Arkrez/bob/cad/rocky_bob/lidar_guard_options.png

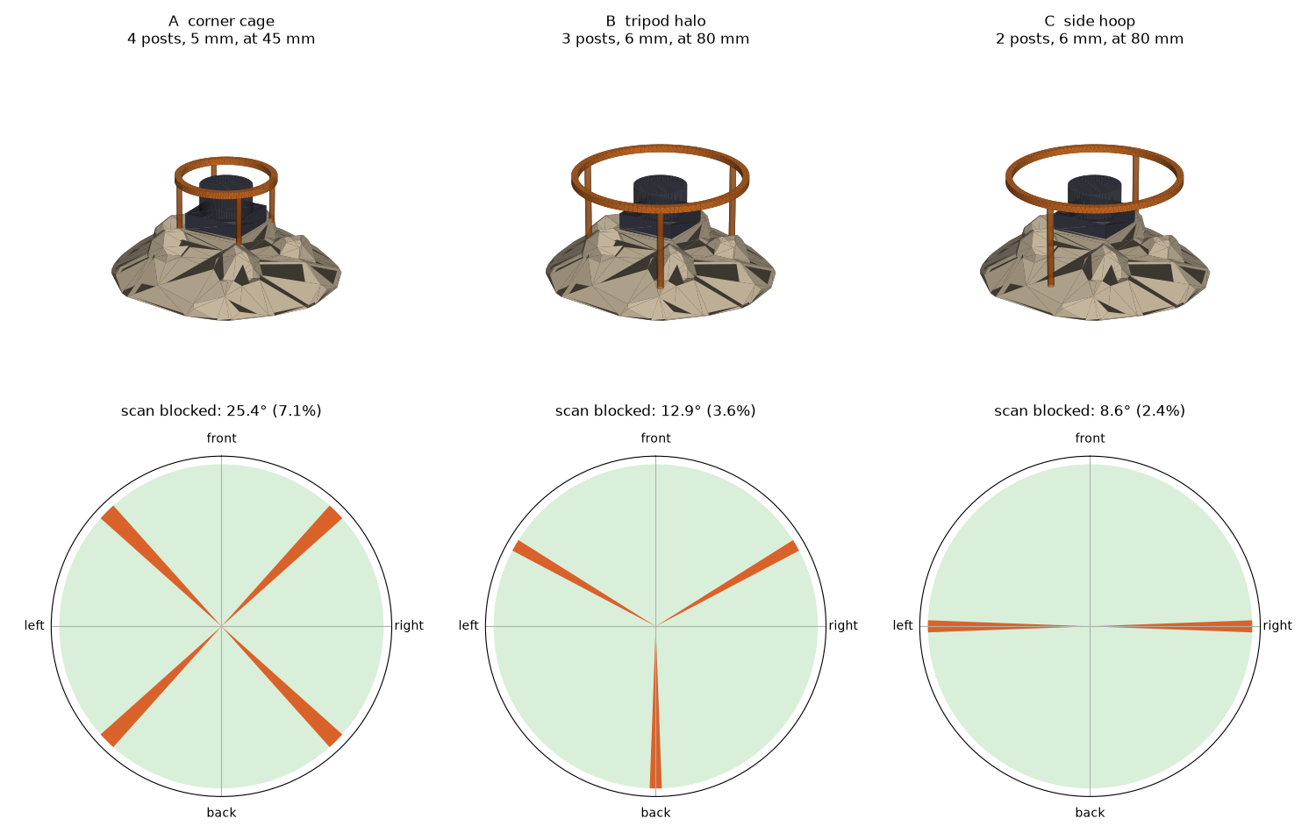
cad/rocky_bob/lidar_guard_options.png
