Arkrez/bob/cad/rocky_bob/tof_nose.png

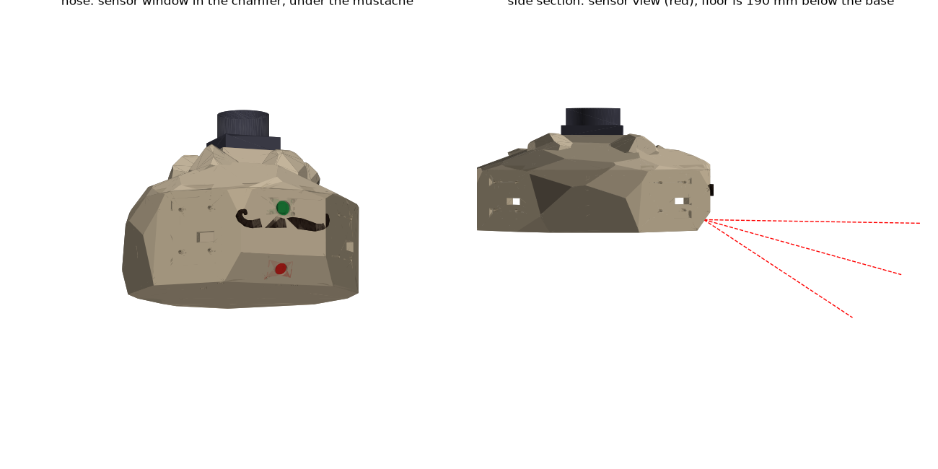
cad/rocky_bob/tof_nose.png
