Arkrez/bob/rl/stairs_terrain.png

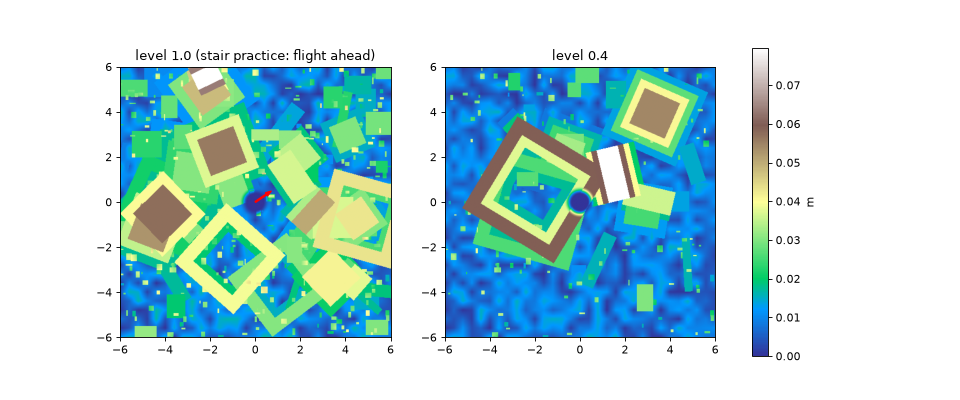
rl/stairs_terrain.png
