Arkrez/bob/webots_quadruped/worlds/.quadruped.jpg

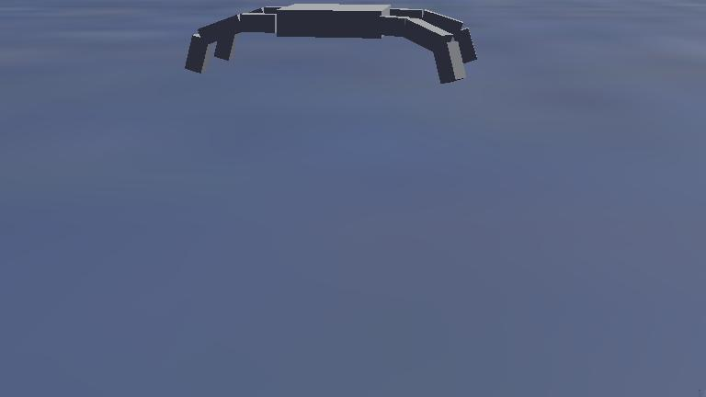
webots_quadruped/worlds/.quadruped.jpg
