Arkrez/bob/cad/rocky_bob/step/rocky_bob_assembly.step

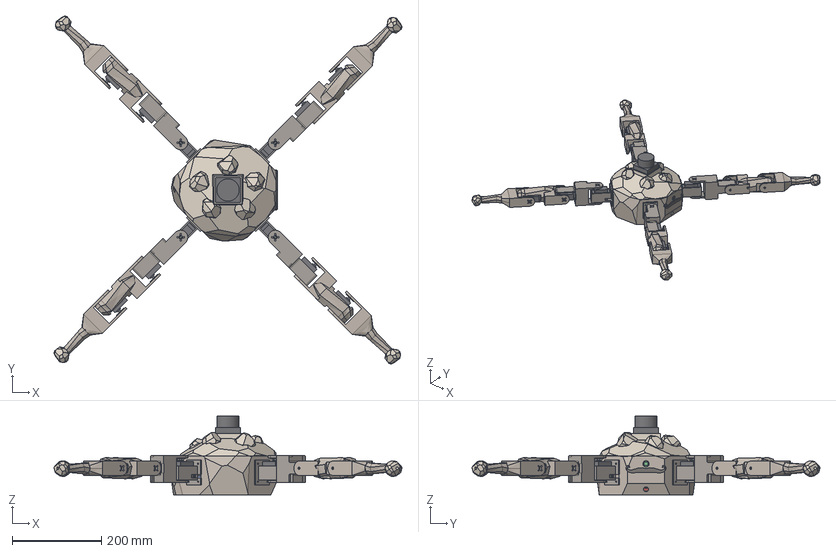
[picture p12: CAD file, 2026-10-24]
cad/rocky_bob/step/rocky_bob_assembly.step
781.7 x 781.7 x 177.3 mm
rock_base
rock_lid
pi5
servo2040
psu
pi_camera
mustache
tof
lidar
leg0_hip_pod x 4
leg0_servo_hip_yaw x 4
leg0_horn_hip_yaw x 4
leg0_coxa x 4
leg0_servo_hip_pitch x 4
leg0_horn_hip_pitch x 4
leg0_femur x 4
leg0_servo_knee x 4
leg0_horn_knee x 4
leg0_tibia x 4
leg0_foot x 4
