Arkrez/bob/cad/rocky_bob/step/mustache.step

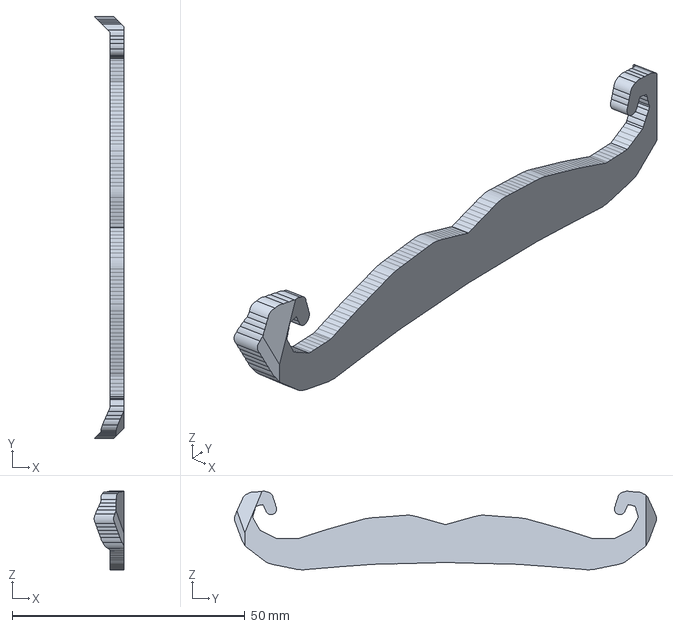
[picture p14: CAD file, 2026-10-24]
cad/rocky_bob/step/mustache.step
6.39 x 90.7 x 16.9 mm
