Arkrez/bob/src/bob_description/meshes/leg1_part2.stl

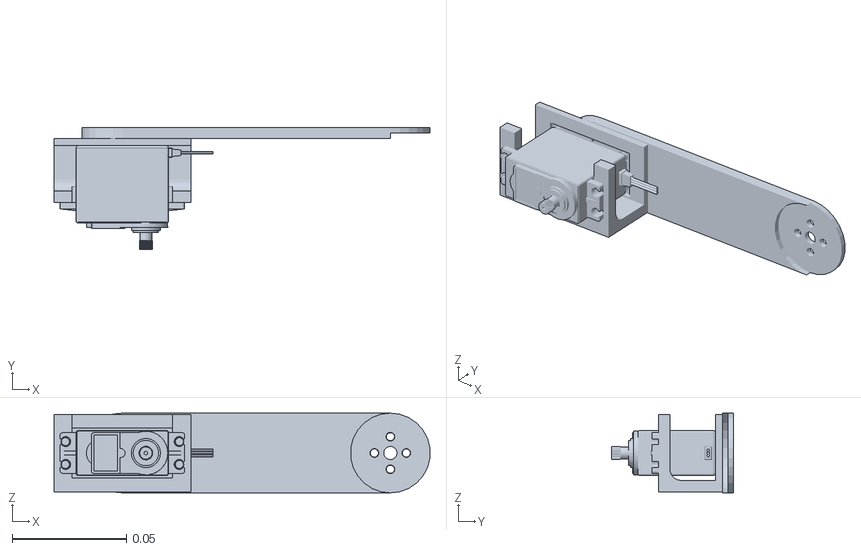
[picture p15: CAD file, 2026-10-13]
src/bob_description/meshes/leg1_part2.stl
0.165 x 0.0537 x 0.035
