Arkrez/bob/src/quadruped_sim/urdf/Quadruped_3D_STL_Files/Stand Link 00.stl

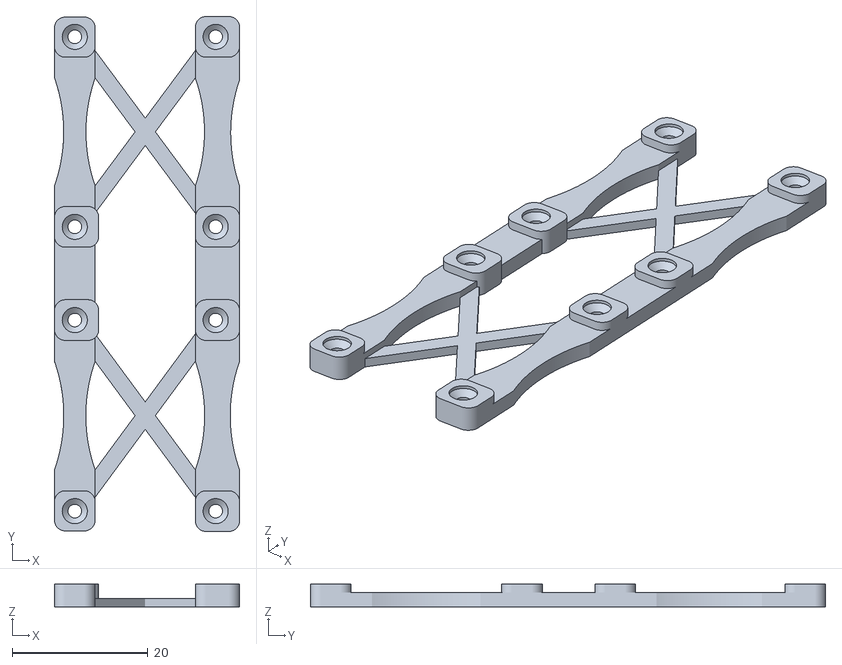
[picture p16: CAD file, 2026-10-04]
src/quadruped_sim/urdf/Quadruped_3D_STL_Files/Stand Link 00.stl
27.3 x 75.9 x 3.35
