Arkrez/bob/webots_quadruped/meshes/leg2_part0.stl

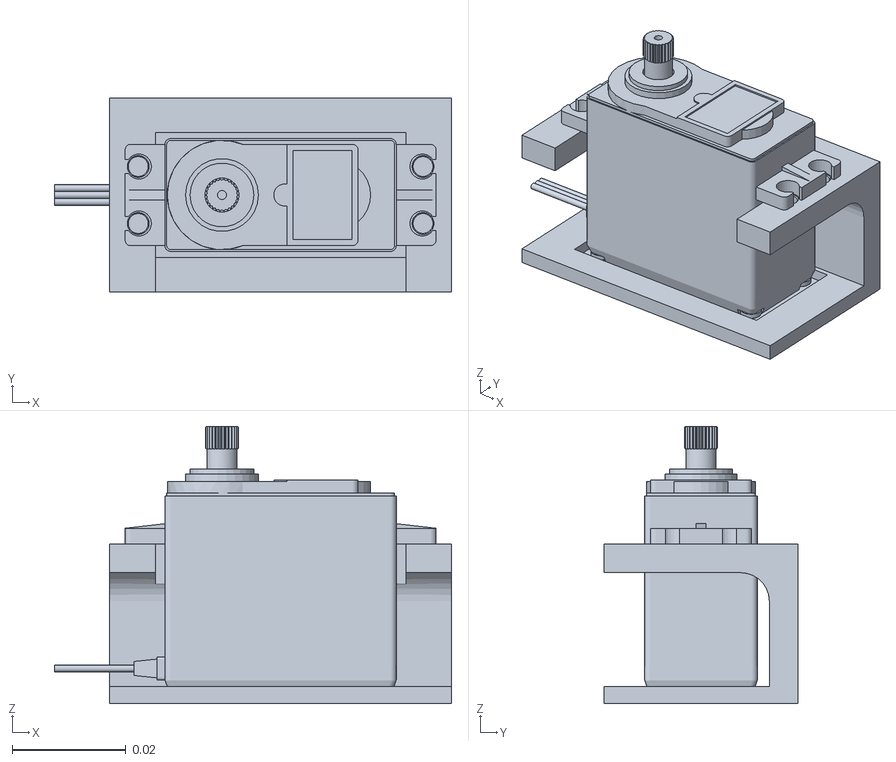
[picture p17: CAD file, 2026-10-13]
webots_quadruped/meshes/leg2_part0.stl
0.0697 x 0.034 x 0.0487
