Arkrez/bob/cad/rocky_bob/sim/meshes/rock_base.stl

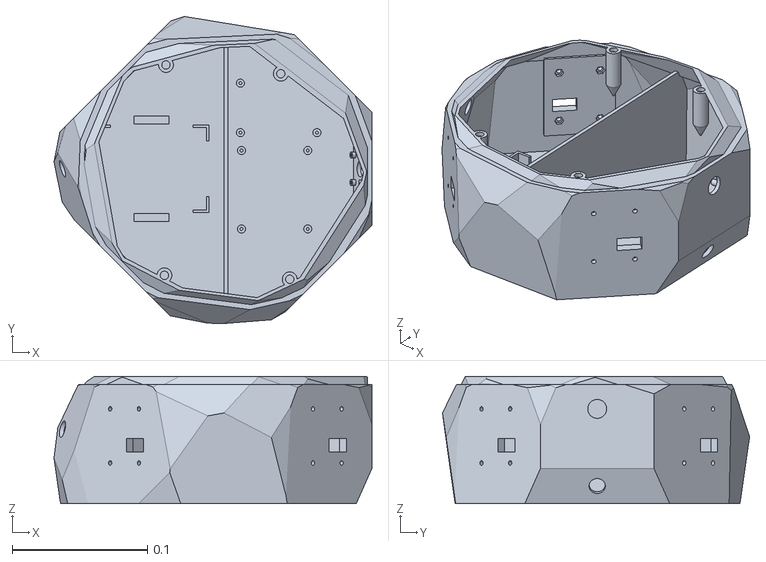
[picture p18: CAD file, 2026-10-24]
cad/rocky_bob/sim/meshes/rock_base.stl
0.235 x 0.227 x 0.094
