Arkrez/bob/cad/rocky_bob/step/rock_base.step

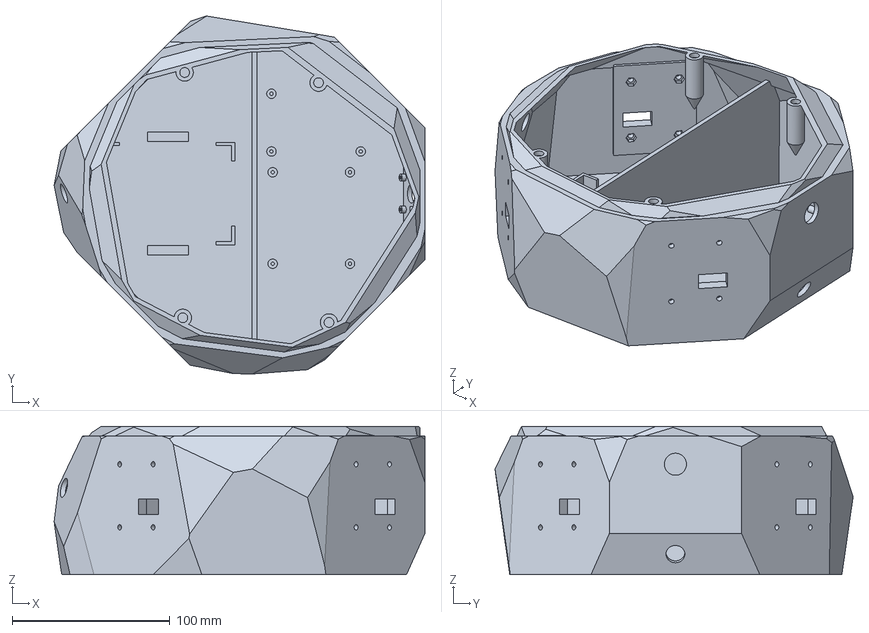
[picture p19: CAD file, 2026-10-24]
cad/rocky_bob/step/rock_base.step
235.1 x 227.0 x 94.0 mm
