Arkrez/bob/src/bob_description/meshes/leg1_part1.stl

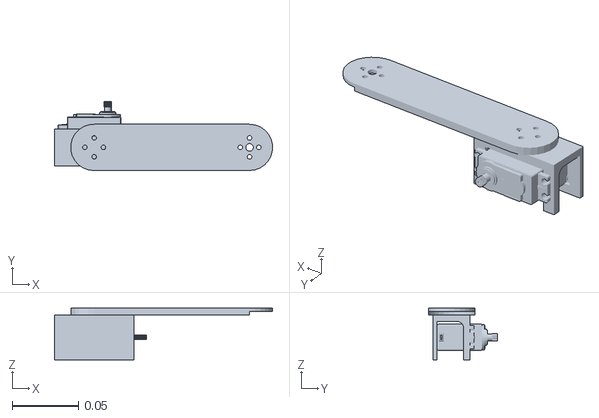
[picture p20: CAD file, 2026-10-13]
src/bob_description/meshes/leg1_part1.stl
0.165 x 0.0522 x 0.039
