Arkrez/bob/src/quadruped_sim/urdf/Quadruped_3D_STL_Files/Body Upper Plate 00.stl

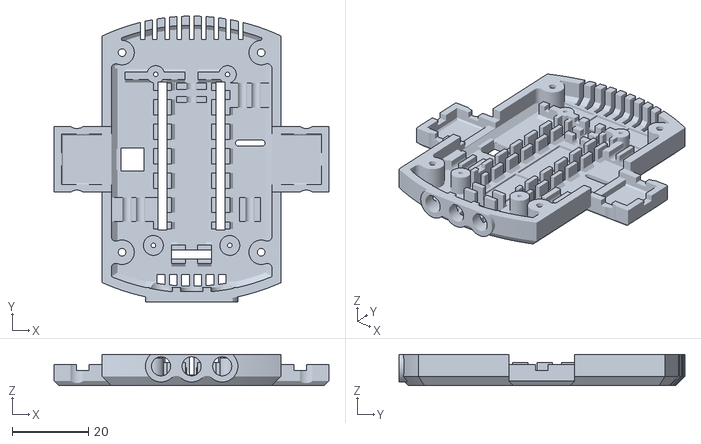
[picture p21: CAD file, 2026-10-04]
src/quadruped_sim/urdf/Quadruped_3D_STL_Files/Body Upper Plate 00.stl
71.9 x 74.8 x 8.15
