Arkrez/bob/cad/rocky_bob/sim/meshes/rock_lid.stl

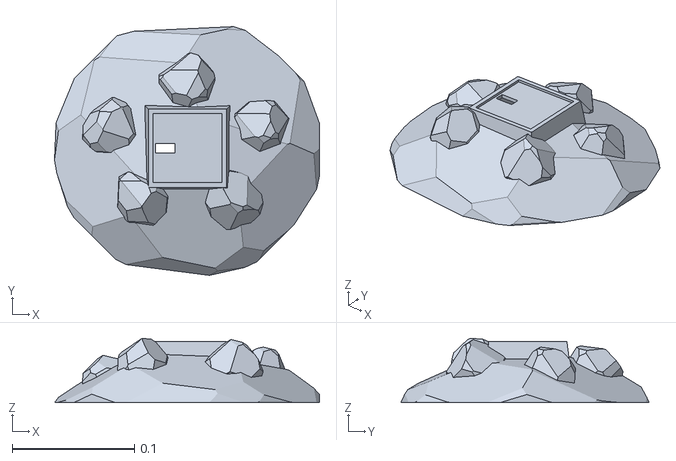
[picture p22: CAD file, 2026-10-24]
cad/rocky_bob/sim/meshes/rock_lid.stl
0.217 x 0.204 x 0.0527
