Arkrez/bob/cad/rocky_bob/step/coxa.step

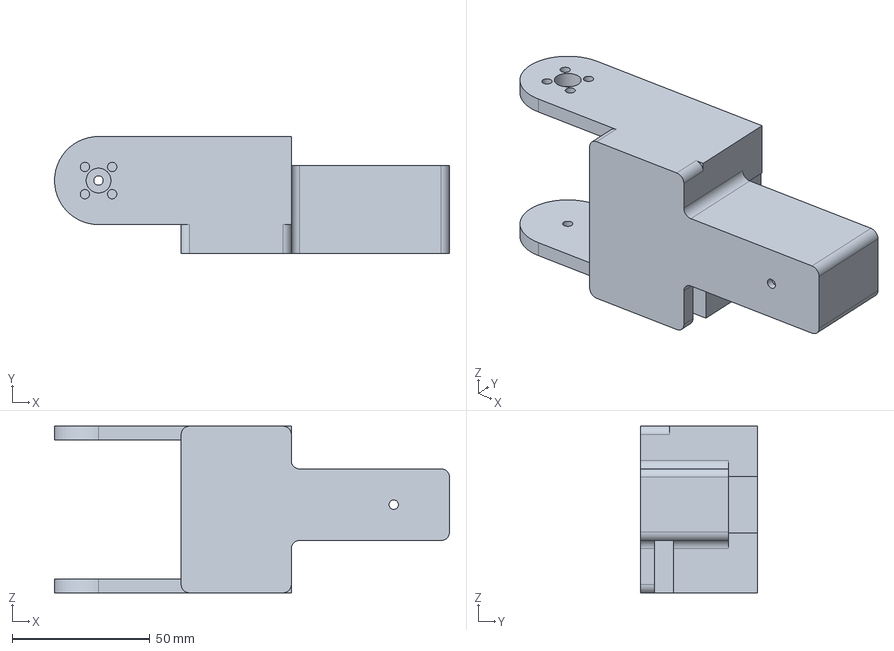
[picture p23: CAD file, 2026-10-24]
cad/rocky_bob/step/coxa.step
143.4 x 42.5 x 60.5 mm
