Arkrez/bob/src/bob_description/meshes/leg0_part3.stl

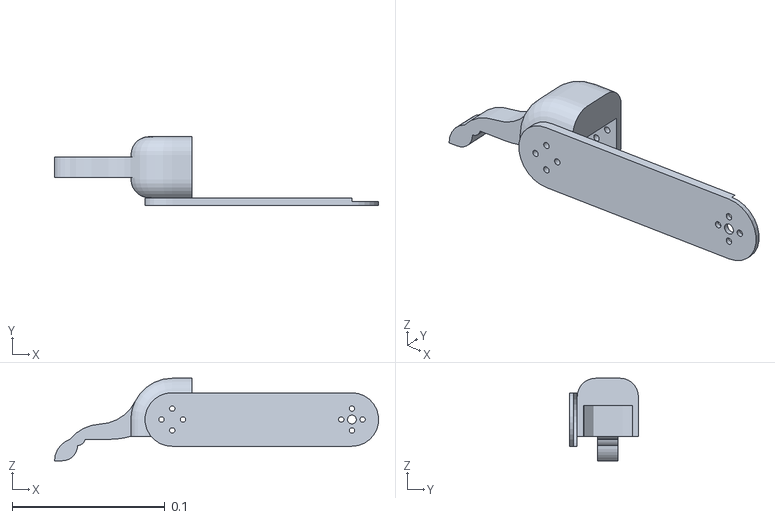
[picture p24: CAD file, 2026-10-13]
src/bob_description/meshes/leg0_part3.stl
0.212 x 0.045 x 0.054
