Arkrez/bob/src/quadruped_sim/urdf/Quadruped_3D_STL_Files/Cross Joint 00.stl

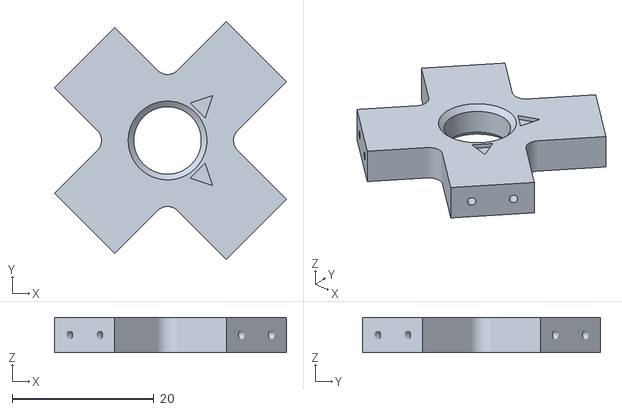
[picture p25: CAD file, 2026-10-04]
src/quadruped_sim/urdf/Quadruped_3D_STL_Files/Cross Joint 00.stl
32.7 x 33.6 x 5.00
