Arkrez/bob/cad/rocky_bob/sim/meshes/mustache.stl

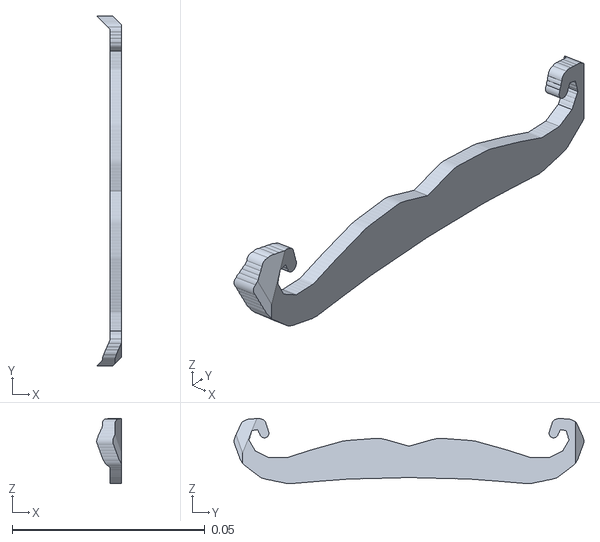
[picture p26: CAD file, 2026-10-24]
cad/rocky_bob/sim/meshes/mustache.stl
0.00639 x 0.0907 x 0.0169
