Arkrez/bob/cad/rocky_bob/step/rock_lid.step

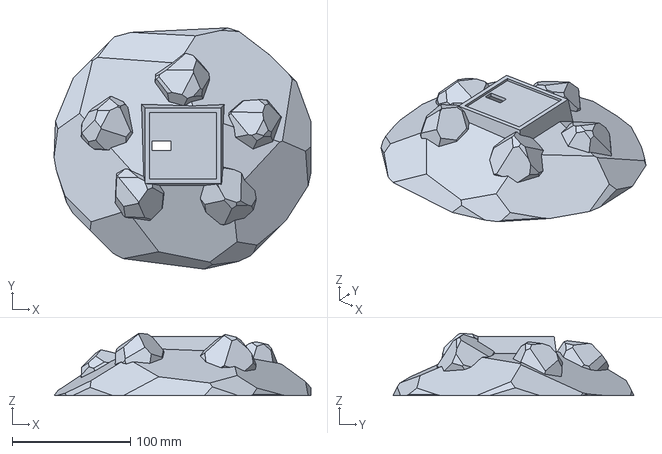
[picture p27: CAD file, 2026-10-24]
cad/rocky_bob/step/rock_lid.step
217.0 x 203.7 x 52.7 mm
