Arkrez/bob/src/bob_description/meshes/base_link.stl

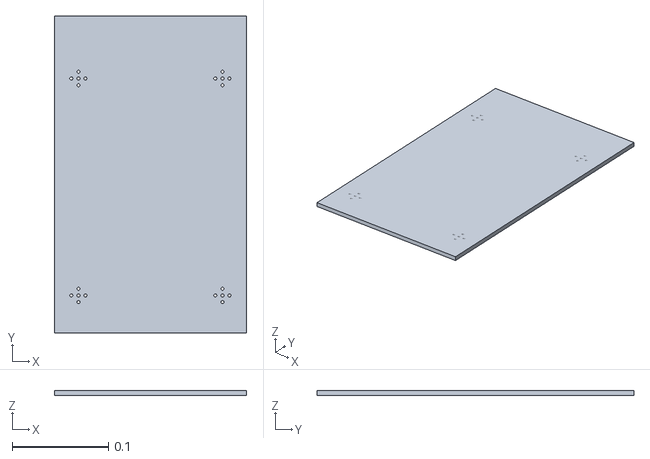
[picture p28: CAD file, 2026-10-13]
src/bob_description/meshes/base_link.stl
0.2 x 0.33 x 0.005
