Arkrez/bob/src/quadruped_sim/urdf/Quadruped_3D_STL_Files/Stand End Plate 00.stl

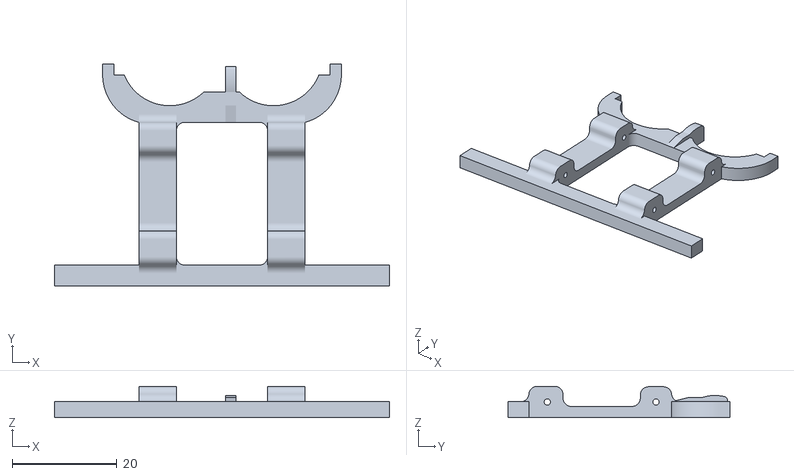
[picture p29: CAD file, 2026-10-04]
src/quadruped_sim/urdf/Quadruped_3D_STL_Files/Stand End Plate 00.stl
64.0 x 42.4 x 6.00
