Arkrez/bob/cad/rocky_bob/sim/meshes/lidar.stl

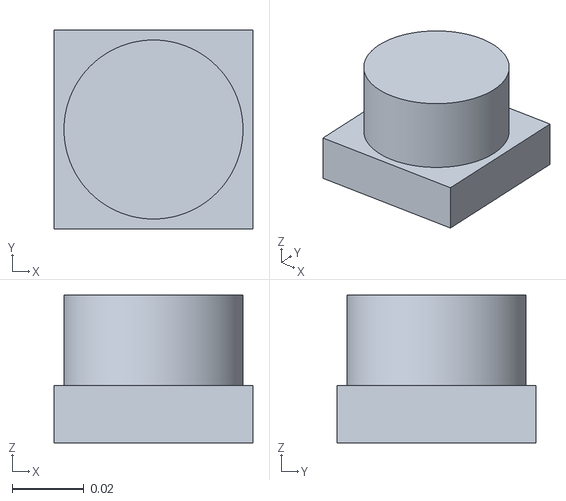
[picture p30: CAD file, 2026-10-24]
cad/rocky_bob/sim/meshes/lidar.stl
0.0556 x 0.0556 x 0.0413
