Arkrez/bob/cad/rocky_bob/step/tibia.step

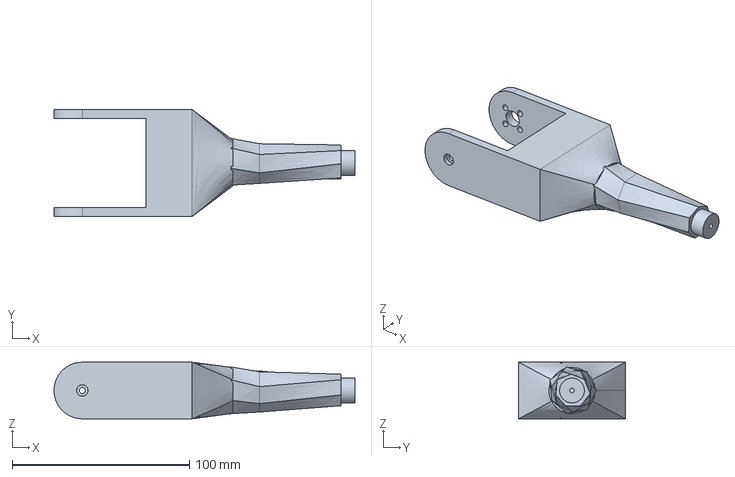
[picture p31: CAD file, 2026-10-24]
cad/rocky_bob/step/tibia.step
170.0 x 60.5 x 32.0 mm
