Arkrez/bob/src/quadruped_sim/urdf/Quadruped_3D_STL_Files/Servo Base Plate 00.stl

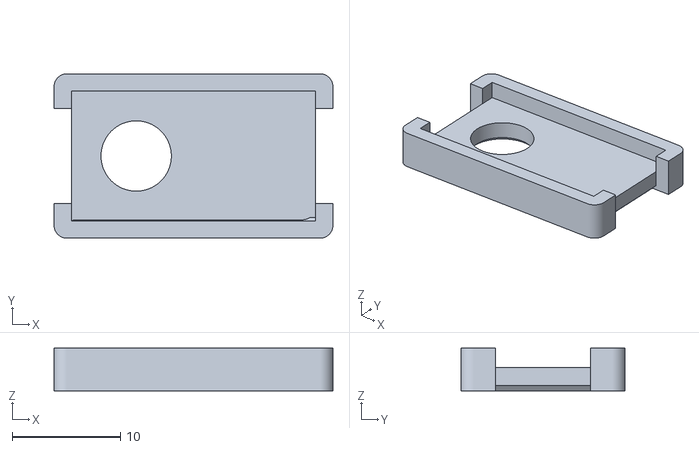
[picture p32: CAD file, 2026-10-04]
src/quadruped_sim/urdf/Quadruped_3D_STL_Files/Servo Base Plate 00.stl
25.8 x 15.2 x 3.95
