Arkrez/bob/cad/rocky_bob/sim/meshes/tof.stl

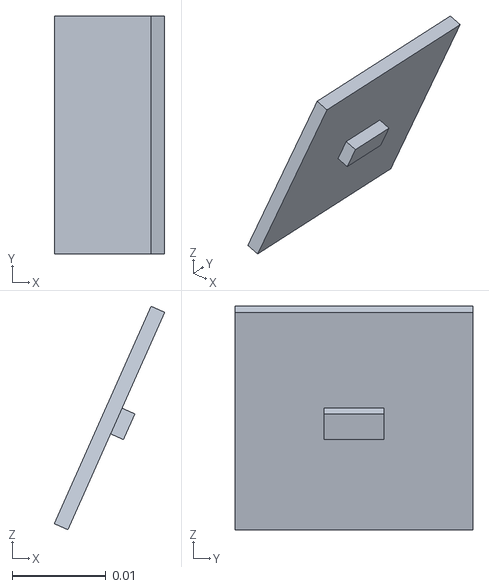
[picture p33: CAD file, 2026-10-24]
cad/rocky_bob/sim/meshes/tof.stl
0.0118 x 0.0254 x 0.0239
