Arkrez/bob/src/quadruped_sim/urdf/Quadruped_3D_STL_Files/Head Face 00.stl

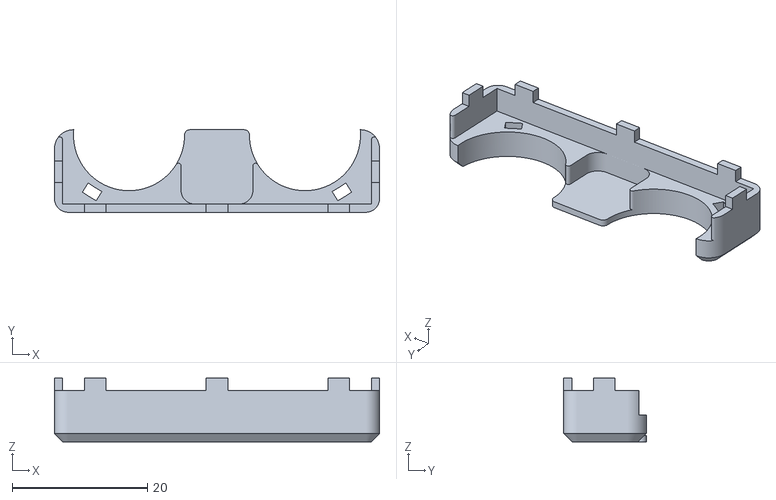
[picture p34: CAD file, 2026-10-04]
src/quadruped_sim/urdf/Quadruped_3D_STL_Files/Head Face 00.stl
48.0 x 12.2 x 9.40
