Arkrez/bob/cad/rocky_bob/sim/meshes/coxa.stl

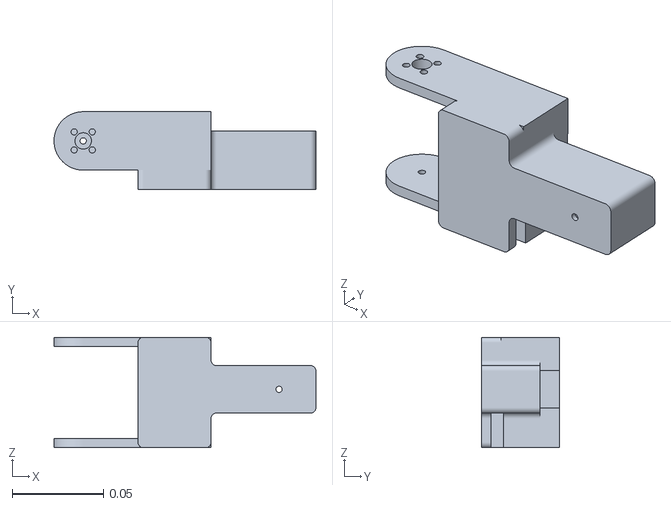
[picture p35: CAD file, 2026-10-23]
cad/rocky_bob/sim/meshes/coxa.stl
0.143 x 0.0425 x 0.0605
