Arkrez/bob/src/quadruped_sim/urdf/Quadruped_3D_STL_Files/Body 00.stl

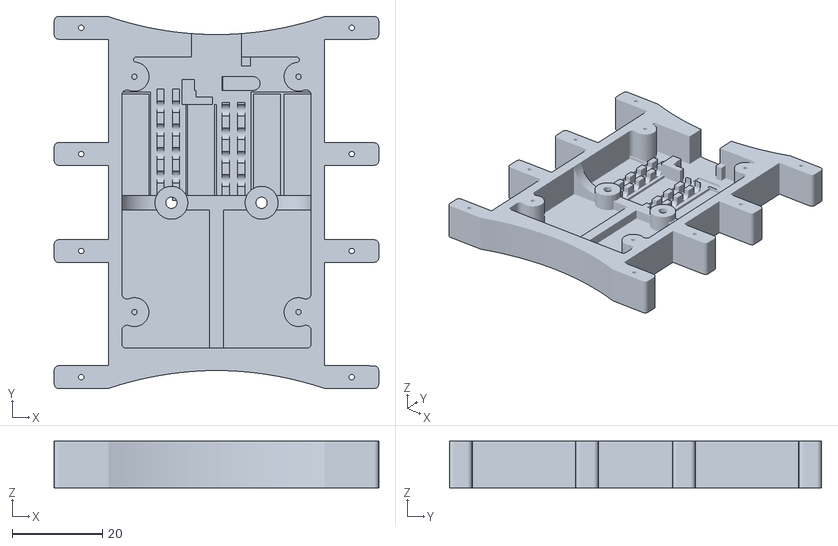
[picture p37: CAD file, 2026-10-04]
src/quadruped_sim/urdf/Quadruped_3D_STL_Files/Body 00.stl
72.0 x 82.5 x 10.4
