Arkrez/bob/cad/rocky_bob/sim/meshes/servo_hip_yaw.stl

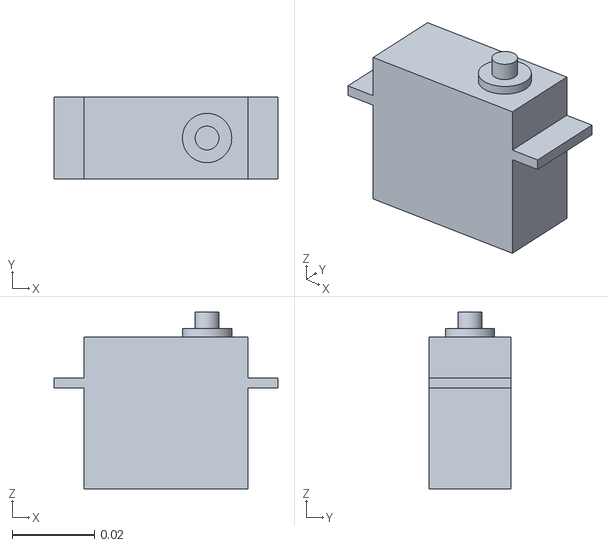
[picture p38: CAD file, 2026-10-23]
cad/rocky_bob/sim/meshes/servo_hip_yaw.stl
0.0545 x 0.02 x 0.043
