Arkrez/bob/cad/rocky_bob/step/foot.step

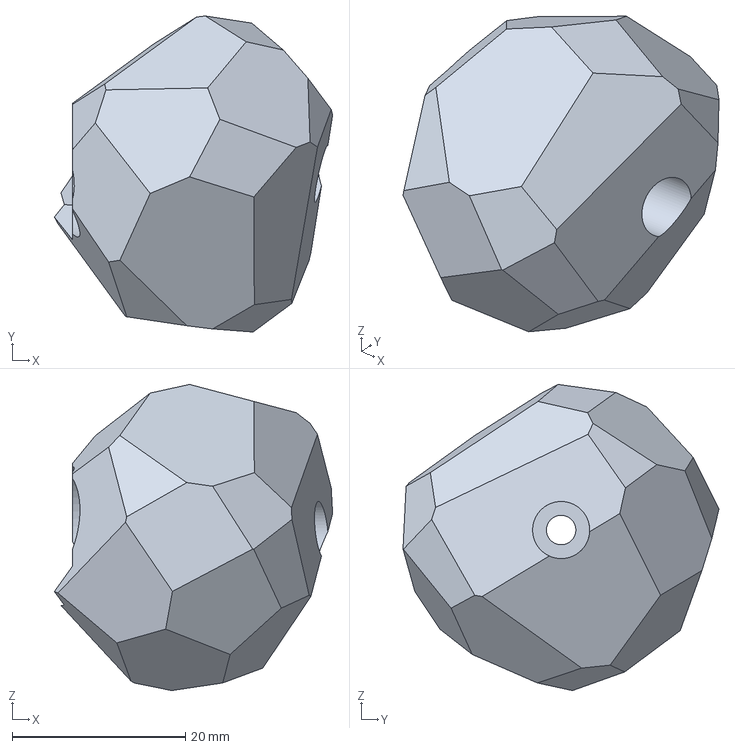
[picture p39: CAD file, 2026-10-24]
cad/rocky_bob/step/foot.step
32.2 x 36.5 x 35.4 mm
