Arkrez/bob/src/quadruped_sim/urdf/Quadruped_3D_STL_Files/Wire Support 00.stl

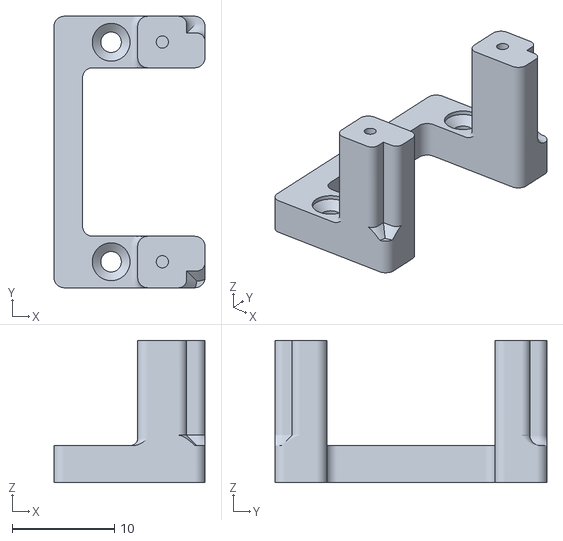
[picture p40: CAD file, 2026-10-04]
src/quadruped_sim/urdf/Quadruped_3D_STL_Files/Wire Support 00.stl
14.8 x 26.6 x 14.0
