Arkrez/bob/cad/rocky_bob/sim/meshes/servo_knee.stl

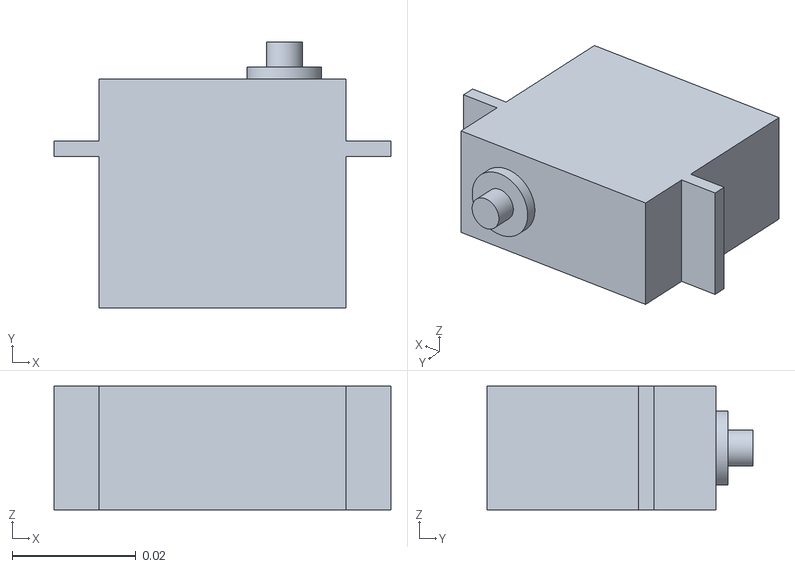
[picture p41: CAD file, 2026-10-23]
cad/rocky_bob/sim/meshes/servo_knee.stl
0.0545 x 0.043 x 0.02
