Arkrez/bob/cad/rocky_bob/step/hip_pod.step

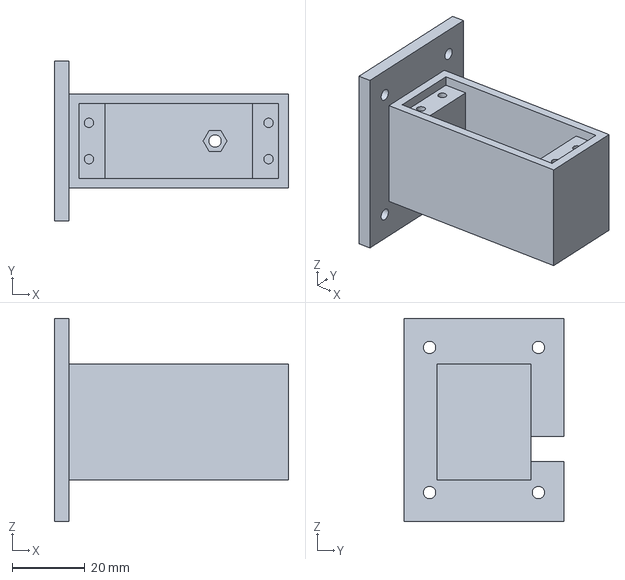
[picture p42: CAD file, 2026-10-24]
cad/rocky_bob/step/hip_pod.step
64.5 x 44.0 x 56.0 mm
