Arkrez/bob/src/quadruped_sim/urdf/Quadruped_3D_STL_Files/Body Lower Plate 00.stl

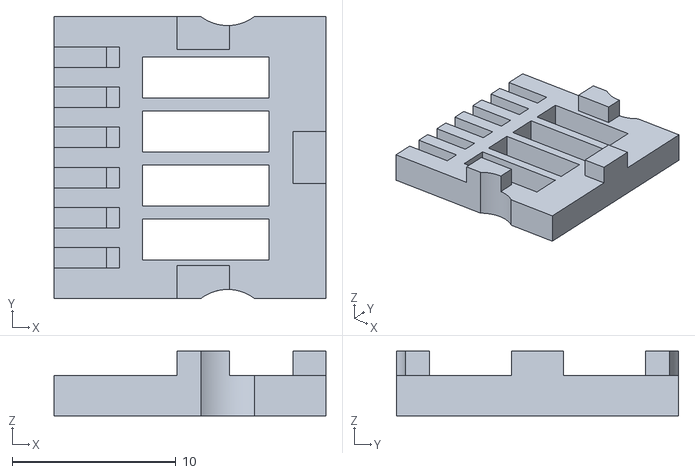
[picture p43: CAD file, 2026-10-04]
src/quadruped_sim/urdf/Quadruped_3D_STL_Files/Body Lower Plate 00.stl
16.6 x 17.2 x 3.95
