Arkrez/bob/cad/rocky_bob/sim/meshes/femur.stl

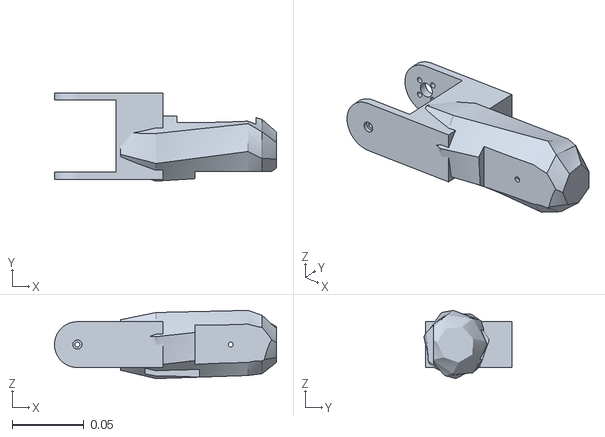
[picture p44: CAD file, 2026-10-23]
cad/rocky_bob/sim/meshes/femur.stl
0.155 x 0.0618 x 0.0477
