Arkrez/bob/cad/rocky_bob/step/femur.step

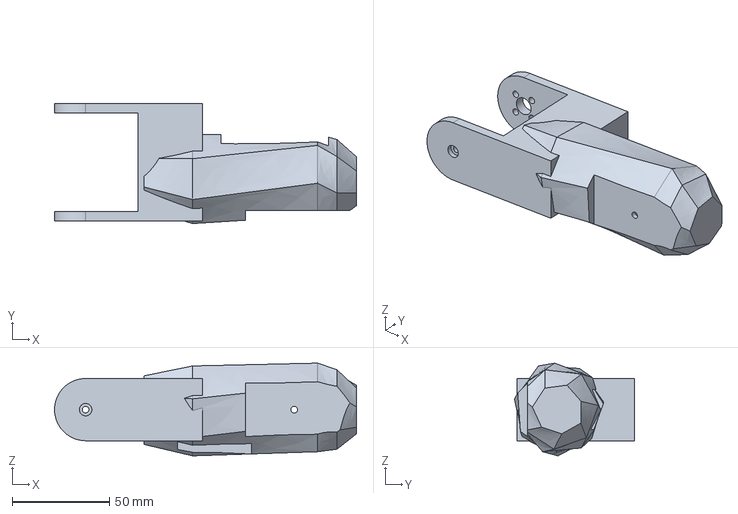
[picture p45: CAD file, 2026-10-24]
cad/rocky_bob/step/femur.step
155.2 x 61.8 x 47.7 mm
