Arkrez/bob/src/quadruped_sim/urdf/Quadruped_3D_STL_Files/Wire Support Cover 00.stl

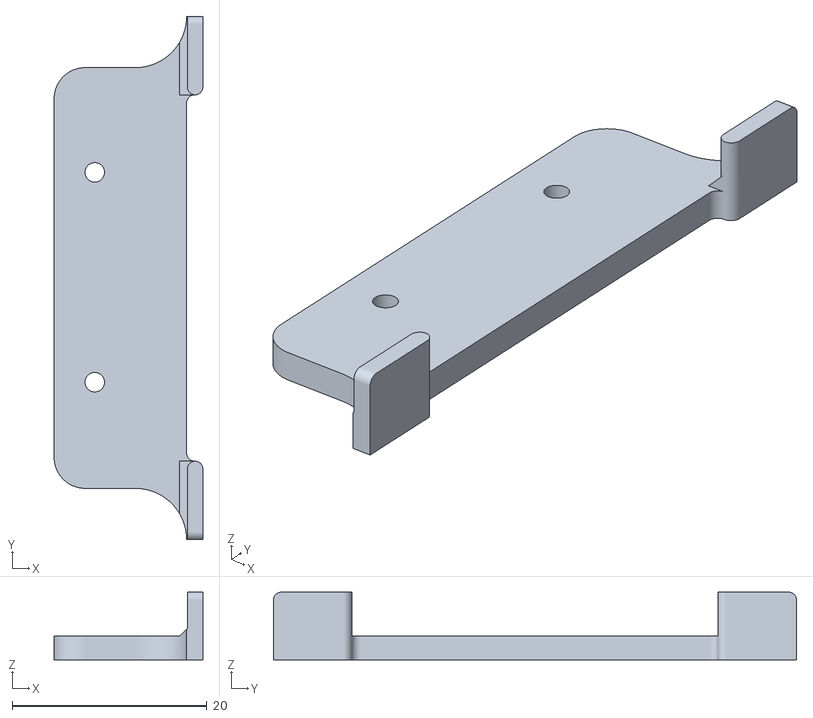
[picture p46: CAD file, 2026-10-04]
src/quadruped_sim/urdf/Quadruped_3D_STL_Files/Wire Support Cover 00.stl
15.3 x 53.7 x 6.95
