Arkrez/bob/cad/rocky_bob/sim/meshes/foot.stl

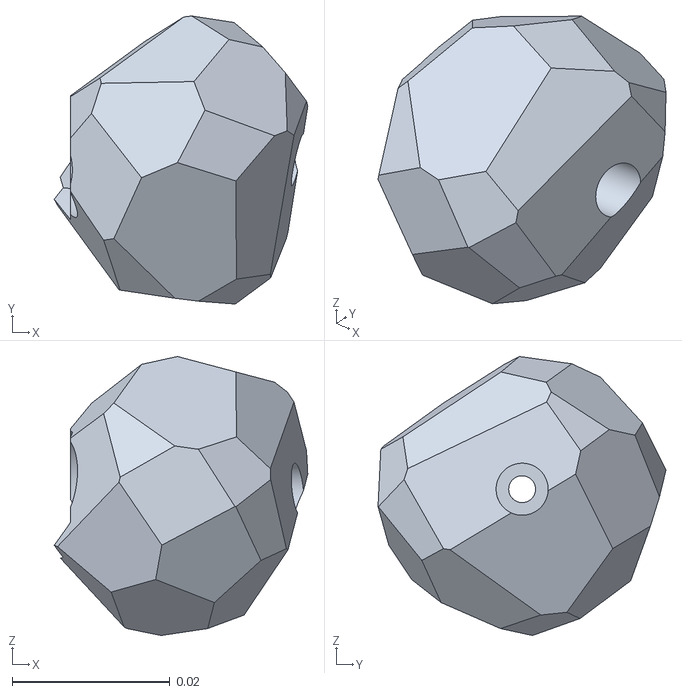
[picture p47: CAD file, 2026-10-23]
cad/rocky_bob/sim/meshes/foot.stl
0.0322 x 0.0365 x 0.0354
