Arkrez/bob/src/quadruped_sim/urdf/Quadruped_3D_STL_Files/Upper Plate 00.stl

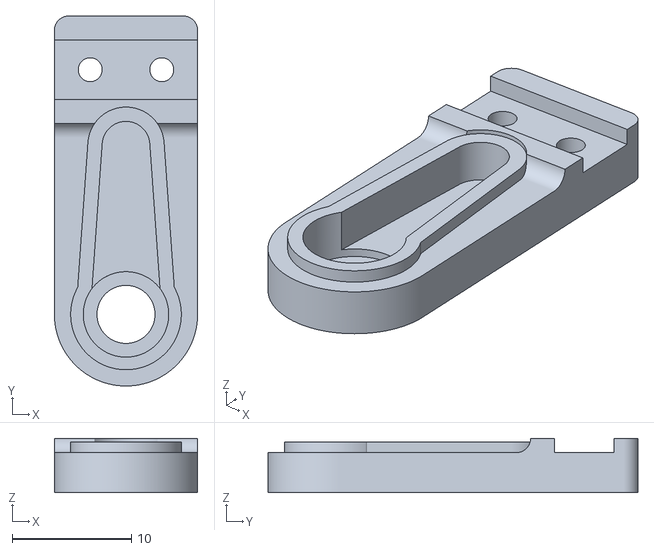
[picture p48: CAD file, 2026-10-04]
src/quadruped_sim/urdf/Quadruped_3D_STL_Files/Upper Plate 00.stl
12.0 x 31.0 x 4.55
