Arkrez/bob/cad/rocky_bob/sim/meshes/tibia.stl

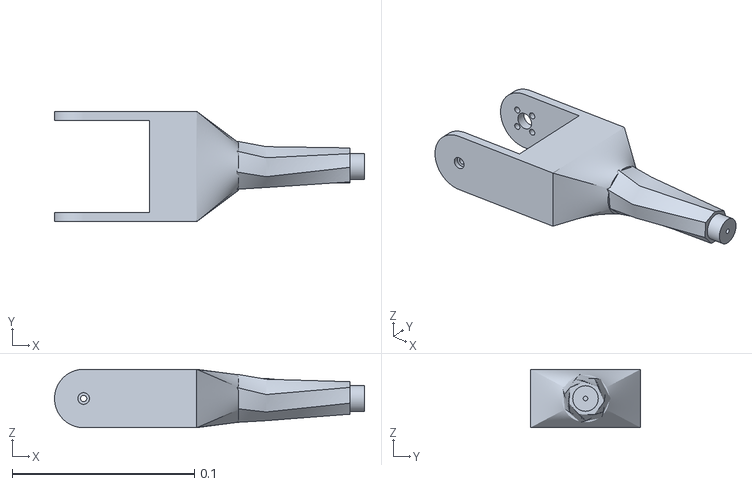
[picture p49: CAD file, 2026-10-23]
cad/rocky_bob/sim/meshes/tibia.stl
0.17 x 0.0605 x 0.032
