Arkrez/bob/cad/rocky_bob/sim/meshes/hip_pod.stl

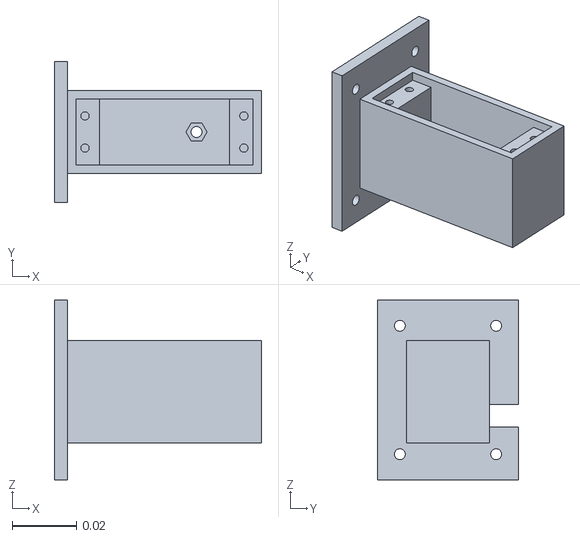
[picture p50: CAD file, 2026-10-23]
cad/rocky_bob/sim/meshes/hip_pod.stl
0.0645 x 0.044 x 0.056
