Arkrez/bob/src/quadruped_sim/urdf/Quadruped_3D_STL_Files/Leg 00.stl

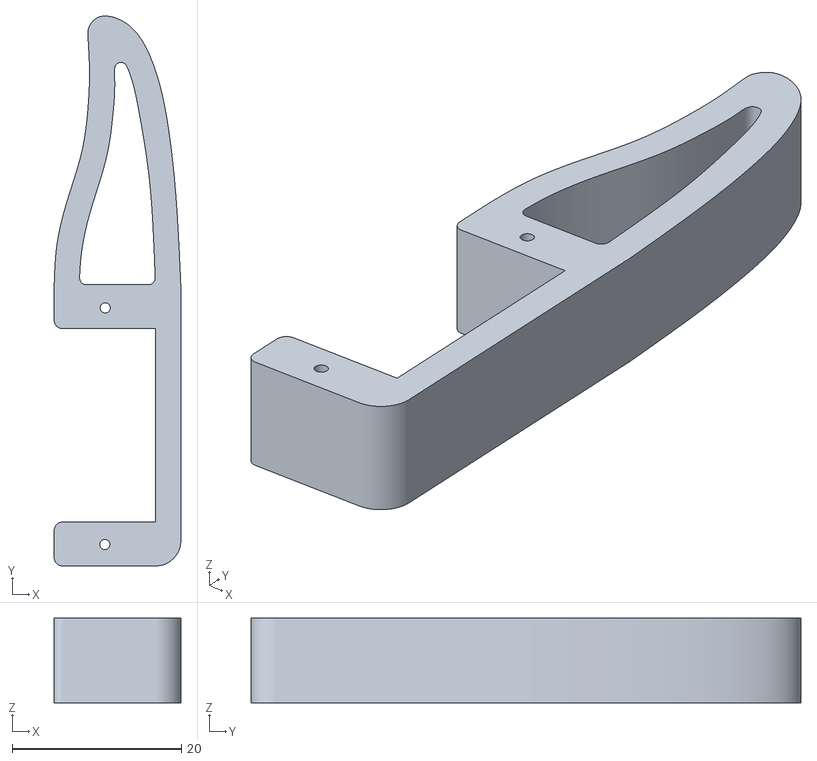
[picture p51: CAD file, 2026-10-04]
src/quadruped_sim/urdf/Quadruped_3D_STL_Files/Leg 00.stl
15.0 x 65.1 x 10.0
