Arkrez/bob/cad/rocky_bob/sim/meshes/pi5.stl

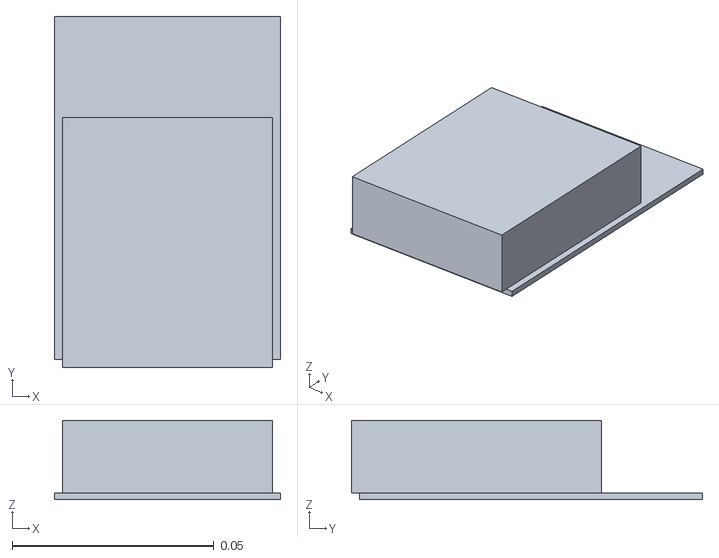
[picture p52: CAD file, 2026-10-23]
cad/rocky_bob/sim/meshes/pi5.stl
0.056 x 0.087 x 0.0196
