Arkrez/bob/src/quadruped_sim/urdf/Quadruped_3D_STL_Files/Battery Connector 00.stl

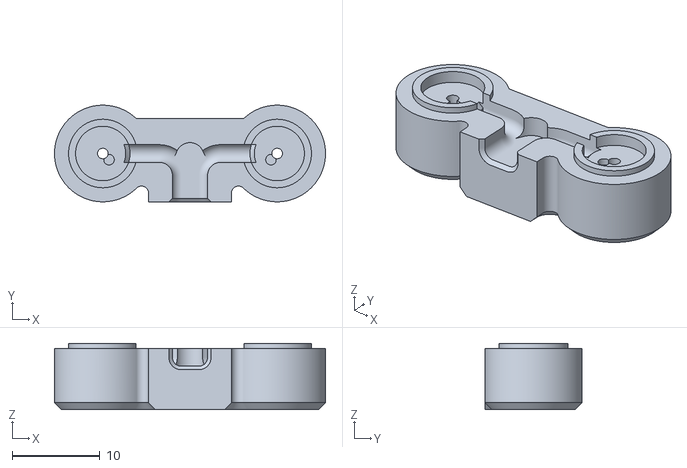
[picture p53: CAD file, 2026-10-04]
src/quadruped_sim/urdf/Quadruped_3D_STL_Files/Battery Connector 00.stl
30.8 x 11.0 x 7.55
