Arkrez/bob/cad/rocky_bob/sim/meshes/horn_knee.stl

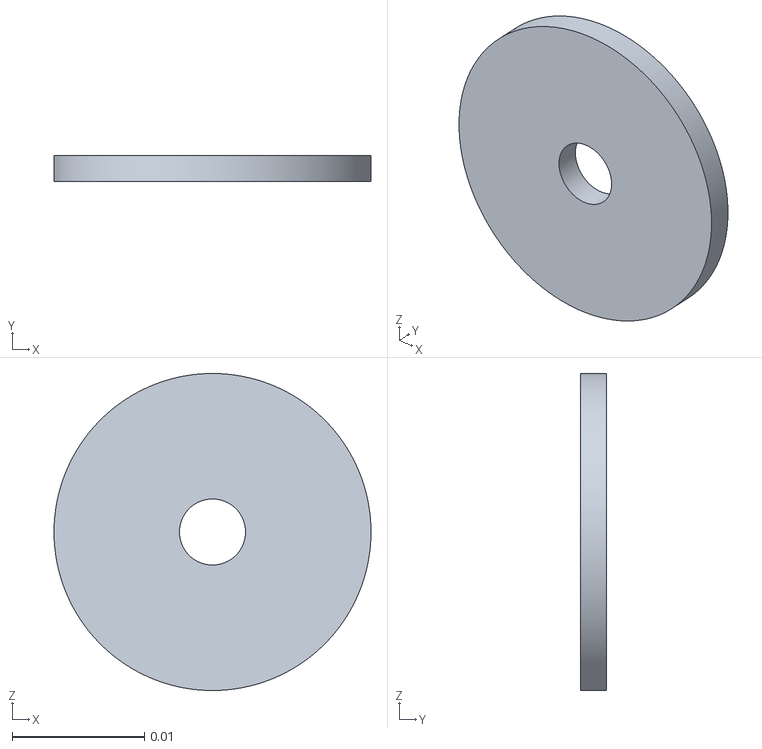
[picture p54: CAD file, 2026-10-23]
cad/rocky_bob/sim/meshes/horn_knee.stl
0.024 x 0.002 x 0.024
