Arkrez/bob/src/quadruped_sim/urdf/Quadruped_3D_STL_Files/Head Eyebrow 00.stl

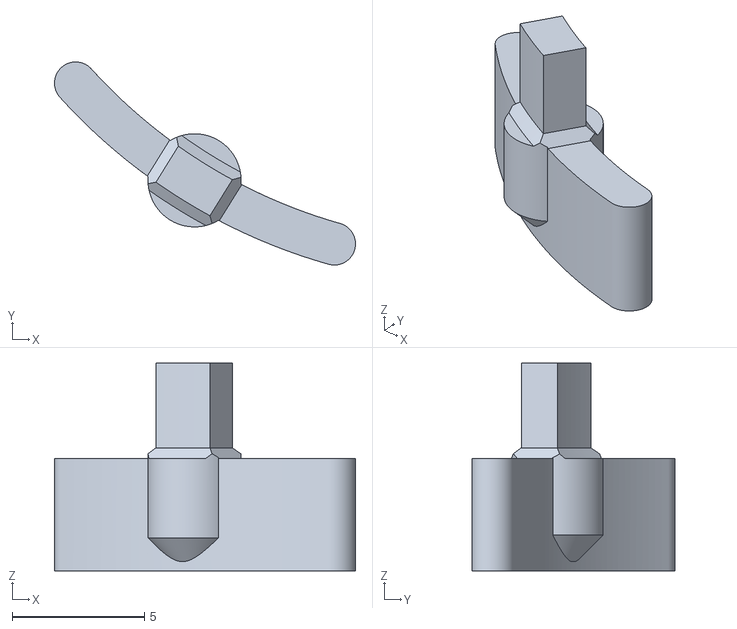
[picture p55: CAD file, 2026-10-04]
src/quadruped_sim/urdf/Quadruped_3D_STL_Files/Head Eyebrow 00.stl
11.4 x 7.67 x 7.85
