Arkrez/bob/src/quadruped_sim/urdf/Quadruped_3D_STL_Files/Lower Plate 00.stl

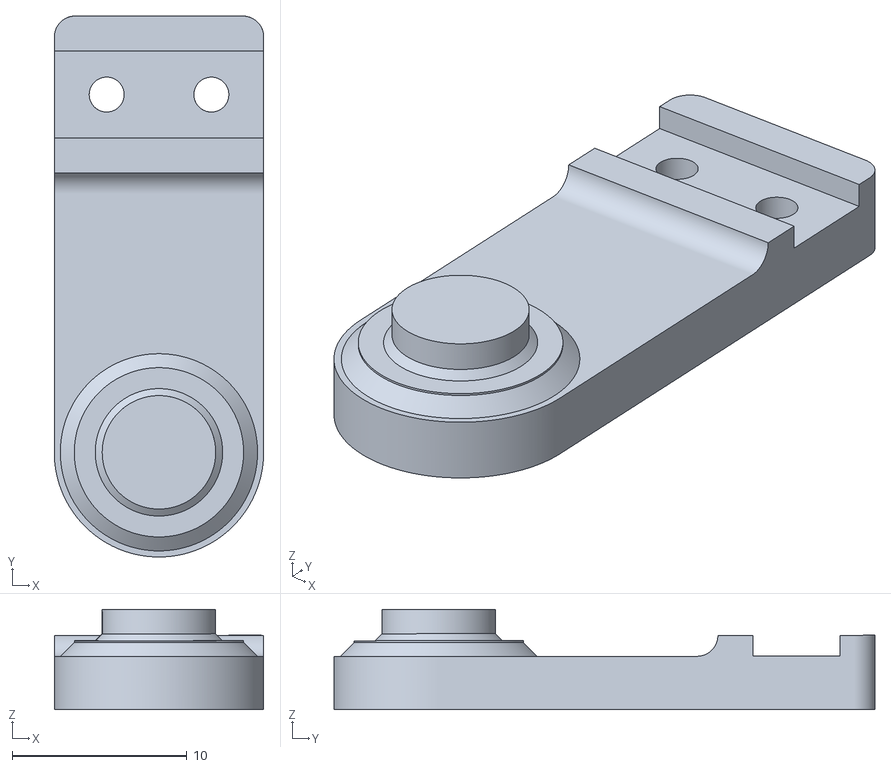
[picture p56: CAD file, 2026-10-04]
src/quadruped_sim/urdf/Quadruped_3D_STL_Files/Lower Plate 00.stl
12.0 x 31.0 x 5.76
