Arkrez/bob/cad/rocky_bob/sim/meshes/pi_camera.stl

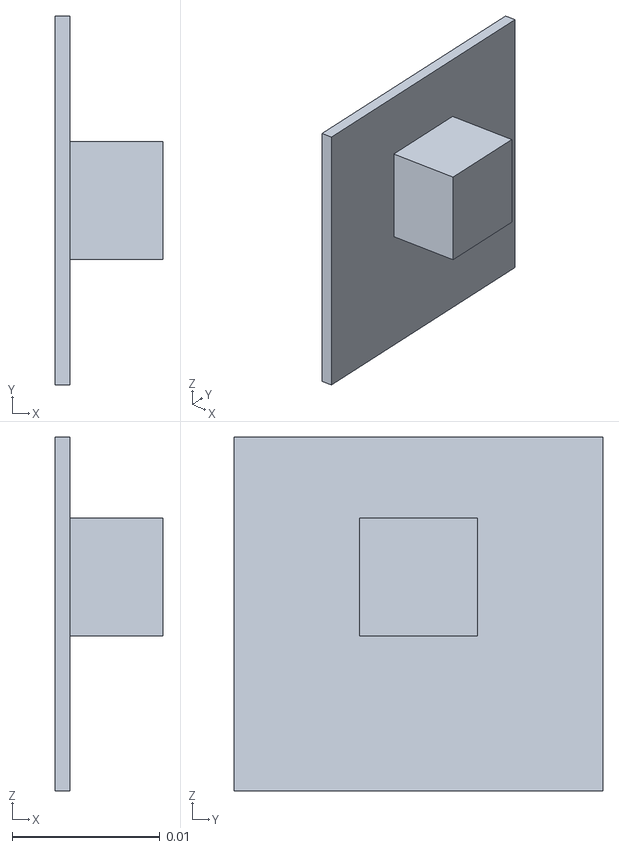
[picture p57: CAD file, 2026-10-23]
cad/rocky_bob/sim/meshes/pi_camera.stl
0.0073 x 0.025 x 0.024
