Arkrez/bob/cad/rocky_bob/sim/meshes/servo2040.stl

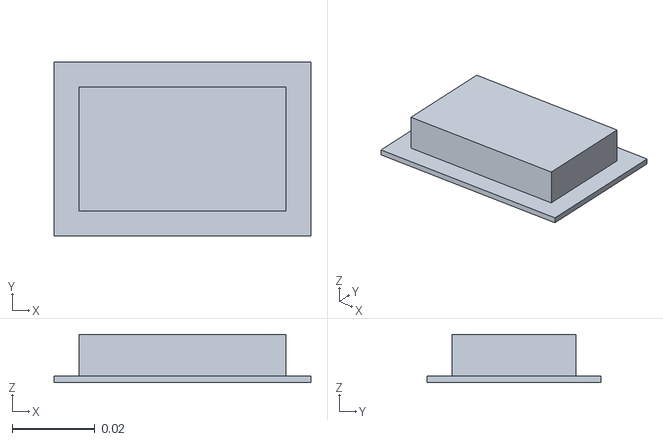
[picture p58: CAD file, 2026-10-23]
cad/rocky_bob/sim/meshes/servo2040.stl
0.062 x 0.042 x 0.0116
