Arkrez/bob/cad/rocky_bob/sim/meshes/psu.stl

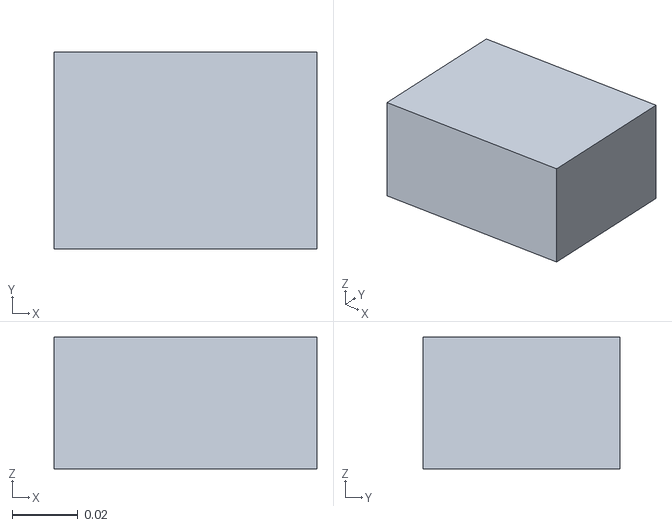
[picture p59: CAD file, 2026-10-23]
cad/rocky_bob/sim/meshes/psu.stl
0.08 x 0.06 x 0.04
