Arkrez/bob/(list of files, cad)

Other CAD files:
webots_quadruped/meshes/leg3_part0.stl
webots_quadruped/meshes/leg3_part2.stl
webots_quadruped/meshes/leg3_part1.stl
src/bob_description/meshes/leg2_part3.stl
webots_quadruped/meshes/leg1_part0.stl
src/bob_description/meshes/leg2_part1.stl
src/quadruped_sim/urdf/Quadruped_3D_STL_Files/Stand Plate 00.stl
cad/rocky_bob/sim/meshes/servo_hip_pitch.stl
cad/rocky_bob/sim/meshes/horn_hip_yaw.stl
cad/rocky_bob/stl/coxa.stl
cad/rocky_bob/stl/femur.stl
cad/rocky_bob/stl/foot.stl
cad/rocky_bob/stl/hip_pod.stl
cad/rocky_bob/stl/mustache.stl
cad/rocky_bob/stl/rock_base.stl
cad/rocky_bob/stl/rock_lid.stl
cad/rocky_bob/stl/tibia.stl
