Arkrez/bob/gz_control_ws/build/gz_ros2_control_demos/symlink_install_manifest.txt

/workspace/gz_control_ws/install/gz_ros2_control_demos/share/gz_ros2_control_demos//launch/ackermann_drive_example.launch.py
/workspace/gz_control_ws/install/gz_ros2_control_demos/share/gz_ros2_control_demos//launch/cart_example_effort.launch.py
/workspace/gz_control_ws/install/gz_ros2_control_demos/share/gz_ros2_control_demos//launch/cart_example_ft_sensor.launch.py
/workspace/gz_control_ws/install/gz_ros2_control_demos/share/gz_ros2_control_demos//launch/cart_example_position.launch.py
/workspace/gz_control_ws/install/gz_ros2_control_demos/share/gz_ros2_control_demos//launch/cart_example_velocity.launch.py
/workspace/gz_control_ws/install/gz_ros2_control_demos/share/gz_ros2_control_demos//launch/cart_example_velocity_custom_plugin.launch.py
/workspace/gz_control_ws/install/gz_ros2_control_demos/share/gz_ros2_control_demos//launch/diff_drive_example.launch.py
/workspace/gz_control_ws/install/gz_ros2_control_demos/share/gz_ros2_control_demos//launch/diff_drive_example_namespaced.launch.py
/workspace/gz_control_ws/install/gz_ros2_control_demos/share/gz_ros2_control_demos//launch/gripper_mimic_joint_example_effort.launch.py
/workspace/gz_control_ws/install/gz_ros2_control_demos/share/gz_ros2_control_demos//launch/gripper_mimic_joint_example_effort.launch.xml
/workspace/gz_control_ws/install/gz_ros2_control_demos/share/gz_ros2_control_demos//launch/gripper_mimic_joint_example_position.launch.py
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
/workspace/gz_control_ws/install/gz_ros2_control_demos/share/gz_ros2_control_demos/environment/library_path.sh
/workspace/gz_control_ws/install/gz_ros2_control_demos/share/gz_ros2_control_demos/environment/library_path.dsv
/workspace/gz_control_ws/install/gz_ros2_control_demos/share/gz_ros2_control_demos//gz_custom_hardware_plugins.xml
/workspace/gz_control_ws/install/gz_ros2_control_demos/share/ament_index/resource_index/package_run_dependencies/gz_ros2_control_demos
/workspace/gz_control_ws/install/gz_ros2_control_demos/share/ament_index/resource_index/parent_prefix_path/gz_ros2_control_demos
/workspace/gz_control_ws/install/gz_ros2_control_demos/share/gz_ros2_control_demos/environment/ament_prefix_path.sh
/workspace/gz_control_ws/install/gz_ros2_control_demos/share/gz_ros2_control_demos/environment/ament_prefix_path.dsv
/workspace/gz_control_ws/install/gz_ros2_control_demos/share/gz_ros2_control_demos/environment/path.sh
/workspace/gz_control_ws/install/gz_ros2_control_demos/share/gz_ros2_control_demos/environment/path.dsv
/workspace/gz_control_ws/install/gz_ros2_control_demos/share/gz_ros2_control_demos/local_setup.bash
/workspace/gz_control_ws/install/gz_ros2_control_demos/share/gz_ros2_control_demos/local_setup.sh
/workspace/gz_control_ws/install/gz_ros2_control_demos/share/gz_ros2_control_demos/local_setup.zsh
/workspace/gz_control_ws/install/gz_ros2_control_demos/share/gz_ros2_control_demos/local_setup.dsv
/workspace/gz_control_ws/install/gz_ros2_control_demos/share/gz_ros2_control_demos/package.dsv
/workspace/gz_control_ws/install/gz_ros2_control_demos/share/ament_index/resource_index/packages/gz_ros2_control_demos
/workspace/gz_control_ws/install/gz_ros2_control_demos/share/ament_index/resource_index/gz_ros2_control__pluginlib__plugin/gz_ros2_control_demos
/workspace/gz_control_ws/install/gz_ros2_control_demos/share/gz_ros2_control_demos/cmake/ament_cmake_export_targets-extras.cmake
/workspace/gz_control_ws/install/gz_ros2_control_demos/share/gz_ros2_control_demos/cmake/gz_ros2_control_demosConfig.cmake
/workspace/gz_control_ws/install/gz_ros2_control_demos/share/gz_ros2_control_demos/cmake/gz_ros2_control_demosConfig-version.cmake
/workspace/gz_control_ws/install/gz_ros2_control_demos/share/gz_ros2_control_demos/package.xml
