Arkrez/bob/build/audio_common/symlink_install_manifest.txt

/workspace/install/audio_common/lib/audio_common/audio_capturer_node
/workspace/install/audio_common/lib/audio_common/audio_player_node
/workspace/install/audio_common/lib/audio_common/music_node
/workspace/install/audio_common/share/audio_common/samples/elevator.wav
/workspace/install/audio_common/lib/audio_common/tts_node
/workspace/install/audio_common/lib/libaudio_common_lib.a
/workspace/install/audio_common/include//audio_common/audio_capturer_node.hpp
/workspace/install/audio_common/include//audio_common/audio_player_node.hpp
/workspace/install/audio_common/include//audio_common/music_node.hpp
/workspace/install/audio_common/include//audio_common/tts_node.hpp
/workspace/install/audio_common/include//audio_common/wave_file.hpp
/workspace/install/audio_common/share/audio_common/environment/library_path.sh
/workspace/install/audio_common/share/audio_common/environment/library_path.dsv
/workspace/install/audio_common/share/ament_index/resource_index/package_run_dependencies/audio_common
/workspace/install/audio_common/share/ament_index/resource_index/parent_prefix_path/audio_common
/workspace/install/audio_common/share/audio_common/environment/ament_prefix_path.sh
/workspace/install/audio_common/share/audio_common/environment/ament_prefix_path.dsv
/workspace/install/audio_common/share/audio_common/environment/path.sh
/workspace/install/audio_common/share/audio_common/environment/path.dsv
/workspace/install/audio_common/share/audio_common/local_setup.bash
/workspace/install/audio_common/share/audio_common/local_setup.sh
/workspace/install/audio_common/share/audio_common/local_setup.zsh
/workspace/install/audio_common/share/audio_common/local_setup.dsv
/workspace/install/audio_common/share/audio_common/package.dsv
/workspace/install/audio_common/share/ament_index/resource_index/packages/audio_common
/workspace/install/audio_common/share/audio_common/cmake/ament_cmake_export_include_directories-extras.cmake
/workspace/install/audio_common/share/audio_common/cmake/ament_cmake_export_libraries-extras.cmake
/workspace/install/audio_common/share/audio_common/cmake/audio_commonConfig.cmake
/workspace/install/audio_common/share/audio_common/cmake/audio_commonConfig-version.cmake
/workspace/install/audio_common/share/audio_common/package.xml
