Arkrez/bob/build/audio_common_msgs/symlink_install_manifest.txt

/workspace/install/audio_common_msgs/share/ament_index/resource_index/rosidl_interfaces/audio_common_msgs
/workspace/install/audio_common_msgs/include/audio_common_msgs/audio_common_msgs/action/detail/tts__functions.h
/workspace/install/audio_common_msgs/include/audio_common_msgs/audio_common_msgs/action/detail/tts__struct.h
/workspace/install/audio_common_msgs/include/audio_common_msgs/audio_common_msgs/action/detail/tts__type_support.h
/workspace/install/audio_common_msgs/include/audio_common_msgs/audio_common_msgs/action/tts.h
/workspace/install/audio_common_msgs/include/audio_common_msgs/audio_common_msgs/msg/audio.h
/workspace/install/audio_common_msgs/include/audio_common_msgs/audio_common_msgs/msg/audio_data.h
/workspace/install/audio_common_msgs/include/audio_common_msgs/audio_common_msgs/msg/audio_info.h
/workspace/install/audio_common_msgs/include/audio_common_msgs/audio_common_msgs/msg/audio_stamped.h
/workspace/install/audio_common_msgs/include/audio_common_msgs/audio_common_msgs/msg/detail/audio__functions.h
/workspace/install/audio_common_msgs/include/audio_common_msgs/audio_common_msgs/msg/detail/audio__struct.h
/workspace/install/audio_common_msgs/include/audio_common_msgs/audio_common_msgs/msg/detail/audio__type_support.h
/workspace/install/audio_common_msgs/include/audio_common_msgs/audio_common_msgs/msg/detail/audio_data__functions.h
/workspace/install/audio_common_msgs/include/audio_common_msgs/audio_common_msgs/msg/detail/audio_data__struct.h
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
/workspace/install/audio_common_msgs/include/audio_common_msgs/audio_common_msgs/action/detail/tts__rosidl_typesupport_introspection_c.h
/workspace/install/audio_common_msgs/include/audio_common_msgs/audio_common_msgs/msg/detail/audio__rosidl_typesupport_introspection_c.h
/workspace/install/audio_common_msgs/include/audio_common_msgs/audio_common_msgs/msg/detail/audio_data__rosidl_typesupport_introspection_c.h
/workspace/install/audio_common_msgs/include/audio_common_msgs/audio_common_msgs/msg/detail/audio_info__rosidl_typesupport_introspection_c.h
/workspace/install/audio_common_msgs/include/audio_common_msgs/audio_common_msgs/msg/detail/audio_stamped__rosidl_typesupport_introspection_c.h
/workspace/install/audio_common_msgs/include/audio_common_msgs/audio_common_msgs/msg/rosidl_typesupport_introspection_c__visibility_control.h
/workspace/install/audio_common_msgs/include/audio_common_msgs/audio_common_msgs/srv/detail/music_play__rosidl_typesupport_introspection_c.h
/workspace/install/audio_common_msgs/include/audio_common_msgs/audio_common_msgs/action/detail/tts__rosidl_typesupport_introspection_cpp.hpp
/workspace/install/audio_common_msgs/include/audio_common_msgs/audio_common_msgs/msg/detail/audio__rosidl_typesupport_introspection_cpp.hpp
/workspace/install/audio_common_msgs/include/audio_common_msgs/audio_common_msgs/msg/detail/audio_data__rosidl_typesupport_introspection_cpp.hpp
/workspace/install/audio_common_msgs/include/audio_common_msgs/audio_common_msgs/msg/detail/audio_info__rosidl_typesupport_introspection_cpp.hpp
/workspace/install/audio_common_msgs/include/audio_common_msgs/audio_common_msgs/msg/detail/audio_stamped__rosidl_typesupport_introspection_cpp.hpp
/workspace/install/audio_common_msgs/include/audio_common_msgs/audio_common_msgs/srv/detail/music_play__rosidl_typesupport_introspection_cpp.hpp
/workspace/install/audio_common_msgs/share/audio_common_msgs/environment/pythonpath.sh
/workspace/install/audio_common_msgs/share/audio_common_msgs/environment/pythonpath.dsv
/workspace/install/audio_common_msgs/local/lib/python3.10/dist-packages/audio_common_msgs-4.0.10-py3.10.egg-info/PKG-INFO
/workspace/install/audio_common_msgs/local/lib/python3.10/dist-packages/audio_common_msgs-4.0.10-py3.10.egg-info/SOURCES.txt
/workspace/install/audio_common_msgs/local/lib/python3.10/dist-packages/audio_common_msgs-4.0.10-py3.10.egg-info/dependency_links.txt
/workspace/install/audio_common_msgs/local/lib/python3.10/dist-packages/audio_common_msgs-4.0.10-py3.10.egg-info/top_level.txt
/workspace/install/audio_common_msgs/local/lib/python3.10/dist-packages/audio_common_msgs/__init__.py
/workspace/install/audio_common_msgs/local/lib/python3.10/dist-packages/audio_common_msgs/_audio_common_msgs_s.ep.rosidl_typesupport_c.c
/workspace/install/audio_common_msgs/local/lib/python3.10/dist-packages/audio_common_msgs/_audio_common_msgs_s.ep.rosidl_typesupport_fastrtps_c.c
/workspace/install/audio_common_msgs/local/lib/python3.10/dist-packages/audio_common_msgs/_audio_common_msgs_s.ep.rosidl_typesupport_introspection_c.c
/workspace/install/audio_common_msgs/local/lib/python3.10/dist-packages/audio_common_msgs/action/__init__.py
/workspace/install/audio_common_msgs/local/lib/python3.10/dist-packages/audio_common_msgs/action/_tts.py
/workspace/install/audio_common_msgs/local/lib/python3.10/dist-packages/audio_common_msgs/action/_tts_s.c
/workspace/install/audio_common_msgs/local/lib/python3.10/dist-packages/audio_common_msgs/audio_common_msgs_s__rosidl_typesupport_c.cpython-310-x86_64-linux-gnu.so
/workspace/install/audio_common_msgs/local/lib/python3.10/dist-packages/audio_common_msgs/audio_common_msgs_s__rosidl_typesupport_fastrtps_c.cpython-310-x86_64-linux-gnu.so
/workspace/install/audio_common_msgs/local/lib/python3.10/dist-packages/audio_common_msgs/audio_common_msgs_s__rosidl_typesupport_introspection_c.cpython-310-x86_64-linux-gnu.so
/workspace/install/audio_common_msgs/local/lib/python3.10/dist-packages/audio_common_msgs/libaudio_common_msgs__rosidl_generator_py.so
/workspace/install/audio_common_msgs/local/lib/python3.10/dist-packages/audio_common_msgs/msg/__init__.py
/workspace/install/audio_common_msgs/local/lib/python3.10/dist-packages/audio_common_msgs/msg/_audio.py
/workspace/install/audio_common_msgs/local/lib/python3.10/dist-packages/audio_common_msgs/msg/_audio_data.py
/workspace/install/audio_common_msgs/local/lib/python3.10/dist-packages/audio_common_msgs/msg/_audio_data_s.c
/workspace/install/audio_common_msgs/local/lib/python3.10/dist-packages/audio_common_msgs/msg/_audio_info.py
/workspace/install/audio_common_msgs/local/lib/python3.10/dist-packages/audio_common_msgs/msg/_audio_info_s.c
/workspace/install/audio_common_msgs/local/lib/python3.10/dist-packages/audio_common_msgs/msg/_audio_s.c
/workspace/install/audio_common_msgs/local/lib/python3.10/dist-packages/audio_common_msgs/msg/_audio_stamped.py
/workspace/install/audio_common_msgs/local/lib/python3.10/dist-packages/audio_common_msgs/msg/_audio_stamped_s.c
/workspace/install/audio_common_msgs/local/lib/python3.10/dist-packages/audio_common_msgs/srv/__init__.py
/workspace/install/audio_common_msgs/local/lib/python3.10/dist-packages/audio_common_msgs/srv/_music_play.py
/workspace/install/audio_common_msgs/local/lib/python3.10/dist-packages/audio_common_msgs/srv/_music_play_s.c
/workspace/install/audio_common_msgs/local/lib/python3.10/dist-packages/audio_common_msgs/audio_common_msgs_s__rosidl_typesupport_fastrtps_c.cpython-310-x86_64-linux-gnu.so
/workspace/install/audio_common_msgs/local/lib/python3.10/dist-packages/audio_common_msgs/audio_common_msgs_s__rosidl_typesupport_introspection_c.cpython-310-x86_64-linux-gnu.so
/workspace/install/audio_common_msgs/local/lib/python3.10/dist-packages/audio_common_msgs/audio_common_msgs_s__rosidl_typesupport_c.cpython-310-x86_64-linux-gnu.so
/workspace/install/audio_common_msgs/share/ament_index/resource_index/rust_packages/audio_common_msgs
/workspace/install/audio_common_msgs/share/audio_common_msgs/rust/Cargo.toml
/workspace/install/audio_common_msgs/share/audio_common_msgs/rust/build.rs
/workspace/install/audio_common_msgs/share/audio_common_msgs/rust/src/action.rs
/workspace/install/audio_common_msgs/share/audio_common_msgs/rust/src/action/rmw.rs
/workspace/install/audio_common_msgs/share/audio_common_msgs/rust/src/lib.rs
/workspace/install/audio_common_msgs/share/audio_common_msgs/rust/src/msg.rs
/workspace/install/audio_common_msgs/share/audio_common_msgs/rust/src/msg/rmw.rs
/workspace/install/audio_common_msgs/share/audio_common_msgs/rust/src/srv.rs
/workspace/install/audio_common_msgs/share/audio_common_msgs/rust/src/srv/rmw.rs
/workspace/install/audio_common_msgs/share/audio_common_msgs/msg/AudioData.idl
/workspace/install/audio_common_msgs/share/audio_common_msgs/msg/AudioInfo.idl
/workspace/install/audio_common_msgs/share/audio_common_msgs/msg/Audio.idl
/workspace/install/audio_common_msgs/share/audio_common_msgs/msg/AudioStamped.idl
/workspace/install/audio_common_msgs/share/audio_common_msgs/action/TTS.idl
/workspace/install/audio_common_msgs/share/audio_common_msgs/srv/MusicPlay.idl
/workspace/install/audio_common_msgs/share/audio_common_msgs/msg/AudioData.msg
/workspace/install/audio_common_msgs/share/audio_common_msgs/msg/AudioInfo.msg
/workspace/install/audio_common_msgs/share/audio_common_msgs/msg/Audio.msg
/workspace/install/audio_common_msgs/share/audio_common_msgs/msg/AudioStamped.msg
/workspace/install/audio_common_msgs/share/audio_common_msgs/action/TTS.action
/workspace/install/audio_common_msgs/share/audio_common_msgs/srv/MusicPlay.srv
/workspace/install/audio_common_msgs/share/audio_common_msgs/srv/MusicPlay_Request.msg
/workspace/install/audio_common_msgs/share/audio_common_msgs/srv/MusicPlay_Response.msg
/workspace/install/audio_common_msgs/share/ament_index/resource_index/package_run_dependencies/audio_common_msgs
/workspace/install/audio_common_msgs/share/ament_index/resource_index/parent_prefix_path/audio_common_msgs
/workspace/install/audio_common_msgs/share/audio_common_msgs/environment/ament_prefix_path.sh
/workspace/install/audio_common_msgs/share/audio_common_msgs/environment/ament_prefix_path.dsv
/workspace/install/audio_common_msgs/share/audio_common_msgs/environment/path.sh
/workspace/install/audio_common_msgs/share/audio_common_msgs/environment/path.dsv
/workspace/install/audio_common_msgs/share/audio_common_msgs/local_setup.bash
/workspace/install/audio_common_msgs/share/audio_common_msgs/local_setup.sh
/workspace/install/audio_common_msgs/share/audio_common_msgs/local_setup.zsh
/workspace/install/audio_common_msgs/share/audio_common_msgs/local_setup.dsv
/workspace/install/audio_common_msgs/share/audio_common_msgs/package.dsv
/workspace/install/audio_common_msgs/share/ament_index/resource_index/packages/audio_common_msgs
/workspace/install/audio_common_msgs/share/audio_common_msgs/cmake/rosidl_cmake-extras.cmake
/workspace/install/audio_common_msgs/share/audio_common_msgs/cmake/ament_cmake_export_dependencies-extras.cmake
/workspace/install/audio_common_msgs/share/audio_common_msgs/cmake/ament_cmake_export_include_directories-extras.cmake
/workspace/install/audio_common_msgs/share/audio_common_msgs/cmake/ament_cmake_export_libraries-extras.cmake
/workspace/install/audio_common_msgs/share/audio_common_msgs/cmake/ament_cmake_export_targets-extras.cmake
/workspace/install/audio_common_msgs/share/audio_common_msgs/cmake/rosidl_cmake_export_typesupport_targets-extras.cmake
/workspace/install/audio_common_msgs/share/audio_common_msgs/cmake/rosidl_cmake_export_typesupport_libraries-extras.cmake
/workspace/install/audio_common_msgs/share/audio_common_msgs/cmake/rosidl_cmake_aggregate_target-extras.cmake
/workspace/install/audio_common_msgs/share/audio_common_msgs/cmake/audio_common_msgsConfig.cmake
/workspace/install/audio_common_msgs/share/audio_common_msgs/cmake/audio_common_msgsConfig-version.cmake
/workspace/install/audio_common_msgs/share/audio_common_msgs/package.xml
