Arkrez/bob/build/quadruped_control/symlink_install_manifest.txt

/workspace/install/quadruped_control//libggml-cpu.so.0.22.0
/workspace/install/quadruped_control//libggml-base.so.0.22.0
/workspace/install/quadruped_control/lib/cmake/ggml/ggml-config.cmake
/workspace/install/quadruped_control/lib/cmake/ggml/ggml-config-version.cmake
/workspace/install/quadruped_control/lib/cmake/whisper/whisper-config.cmake
/workspace/install/quadruped_control/lib/cmake/whisper/whisper-config-version.cmake
/workspace/install/quadruped_control/lib/pkgconfig/whisper.pc
/workspace/install/quadruped_control/lib/cmake/parakeet/parakeet-config.cmake
/workspace/install/quadruped_control/lib/cmake/parakeet/parakeet-config-version.cmake
/workspace/install/quadruped_control/lib/pkgconfig/parakeet.pc
/workspace/install/quadruped_control/lib/quadruped_control/quadruped
/workspace/install/quadruped_control/share/ament_index/resource_index/package_run_dependencies/quadruped_control
/workspace/install/quadruped_control/share/ament_index/resource_index/parent_prefix_path/quadruped_control
/workspace/install/quadruped_control/share/quadruped_control/environment/ament_prefix_path.sh
/workspace/install/quadruped_control/share/quadruped_control/environment/ament_prefix_path.dsv
/workspace/install/quadruped_control/share/quadruped_control/environment/path.sh
/workspace/install/quadruped_control/share/quadruped_control/environment/path.dsv
/workspace/install/quadruped_control/share/quadruped_control/local_setup.bash
/workspace/install/quadruped_control/share/quadruped_control/local_setup.sh
/workspace/install/quadruped_control/share/quadruped_control/local_setup.zsh
/workspace/install/quadruped_control/share/quadruped_control/local_setup.dsv
/workspace/install/quadruped_control/share/quadruped_control/package.dsv
/workspace/install/quadruped_control/share/ament_index/resource_index/packages/quadruped_control
/workspace/install/quadruped_control/share/quadruped_control/cmake/quadruped_controlConfig.cmake
/workspace/install/quadruped_control/share/quadruped_control/cmake/quadruped_controlConfig-version.cmake
/workspace/install/quadruped_control/share/quadruped_control/package.xml
