Arkrez/bob/build/quadruped_sim/symlink_install_manifest.txt

/workspace/install/quadruped_sim/share/quadruped_sim/urdf/quadruped.urdf.xacro
/workspace/install/quadruped_sim/share/quadruped_sim/worlds/quadruped_world.sdf
/workspace/install/quadruped_sim/share/quadruped_sim/launch/gazebo_sim.launch.py
/workspace/install/quadruped_sim/share/quadruped_sim/config/quadruped_controllers.yaml
/workspace/install/quadruped_sim/share/ament_index/resource_index/package_run_dependencies/quadruped_sim
/workspace/install/quadruped_sim/share/ament_index/resource_index/parent_prefix_path/quadruped_sim
/workspace/install/quadruped_sim/share/quadruped_sim/environment/ament_prefix_path.sh
/workspace/install/quadruped_sim/share/quadruped_sim/environment/ament_prefix_path.dsv
/workspace/install/quadruped_sim/share/quadruped_sim/environment/path.sh
/workspace/install/quadruped_sim/share/quadruped_sim/environment/path.dsv
/workspace/install/quadruped_sim/share/quadruped_sim/local_setup.bash
/workspace/install/quadruped_sim/share/quadruped_sim/local_setup.sh
/workspace/install/quadruped_sim/share/quadruped_sim/local_setup.zsh
/workspace/install/quadruped_sim/share/quadruped_sim/local_setup.dsv
/workspace/install/quadruped_sim/share/quadruped_sim/package.dsv
/workspace/install/quadruped_sim/share/ament_index/resource_index/packages/quadruped_sim
/workspace/install/quadruped_sim/share/quadruped_sim/cmake/quadruped_simConfig.cmake
/workspace/install/quadruped_sim/share/quadruped_sim/cmake/quadruped_simConfig-version.cmake
/workspace/install/quadruped_sim/share/quadruped_sim/package.xml
