Arkrez/bob/build/voice_control/symlink_install_manifest.txt

/workspace/install/voice_control/share/ament_index/resource_index/package_run_dependencies/voice_control
/workspace/install/voice_control/share/ament_index/resource_index/parent_prefix_path/voice_control
/workspace/install/voice_control/share/voice_control/environment/ament_prefix_path.sh
/workspace/install/voice_control/share/voice_control/environment/ament_prefix_path.dsv
/workspace/install/voice_control/share/voice_control/environment/path.sh
/workspace/install/voice_control/share/voice_control/environment/path.dsv
/workspace/install/voice_control/share/voice_control/local_setup.bash
/workspace/install/voice_control/share/voice_control/local_setup.sh
/workspace/install/voice_control/share/voice_control/local_setup.zsh
/workspace/install/voice_control/share/voice_control/local_setup.dsv
/workspace/install/voice_control/share/voice_control/package.dsv
/workspace/install/voice_control/share/ament_index/resource_index/packages/voice_control
/workspace/install/voice_control/share/voice_control/cmake/voice_controlConfig.cmake
/workspace/install/voice_control/share/voice_control/cmake/voice_controlConfig-version.cmake
/workspace/install/voice_control/share/voice_control/package.xml
