Arkrez/bob/quadruped_webots.urdf

<?xml version="1.0" ?>
<!-- =================================================================================== -->
<!-- |    This document was autogenerated by xacro from /workspace/src/quadruped_sim/urdf/quadruped.urdf.xacro | -->
<!-- |    EDITING THIS FILE BY HAND IS NOT RECOMMENDED                                 | -->
<!-- =================================================================================== -->
<robot name="quadruped">
  <!-- ============================================================
       SYNCHRONIZED KDL / WEBOTS MODEL

       Leg numbering:

         0 = FRONT LEFT
         1 = FRONT RIGHT
         2 = BACK LEFT
         3 = BACK RIGHT

       Coordinate convention:

         +X = forward
         +Y = left
         +Z = up
       ============================================================ -->
  <!-- BODY -->
  <!-- KDL GEOMETRY -->
  <!-- JOINT LIMITS -->
  <!-- MASSES -->
  <!-- MATERIALS -->
  <material name="body_grey">
    <color rgba="0.25 0.25 0.28 1"/>
  </material>
  <material name="leg_orange">
    <color rgba="0.85 0.45 0.1 1"/>
  </material>
  <material name="foot_black">
    <color rgba="0.05 0.05 0.05 1"/>
  </material>
  <!-- INERTIA HELPERS -->
  <!-- BASE LINK -->
  <link name="base_link">
    <visual>
      <origin rpy="0 0 0" xyz="0 0 0"/>
      <geometry>
        <box size="0.15239999999999998 0.15239999999999998 0.038099999999999995"/>
      </geometry>
      <material name="body_grey"/>
    </visual>
    <collision>
      <origin rpy="0 0 0" xyz="0 0 0"/>
      <geometry>
        <box size="0.15239999999999998 0.15239999999999998 0.038099999999999995"/>
      </geometry>
    </collision>
    <inertial>
      <origin rpy="0 0 0" xyz="0 0 0"/>
      <mass value="0.6"/>
      <inertia ixx="0.0012338684999999997" ixy="0" ixz="0" iyy="0.0012338684999999997" iyz="0" izz="0.0023225759999999994"/>
    </inertial>
  </link>
  <!-- LEG MACRO -->
  <!-- ============================================================
       LEG POSITIONS

                   +X FORWARD

              0 FL       1 FR

              2 BL       3 BR

                   -X BACK
       ============================================================ -->
  <!-- 0 FRONT LEFT -->
  <!-- JOINT 1 -->
  <joint name="joint1_leg0" type="revolute">
    <parent link="base_link"/>
    <child link="leg0_link1"/>
    <origin rpy="0 0 0" xyz="0.07619999999999999 0.07619999999999999 0"/>
    <axis xyz="0 0 1"/>
    <limit effort="2.0" lower="-1.5707963267948966" upper="1.5707963267948966" velocity="3.0"/>
  </joint>
  <!-- LINK 1 -->
  <link name="leg0_link1">
    <visual>
      <origin rpy="0 0 0" xyz="0 0.0254 0"/>
      <geometry>
        <box size="0.0254 0.0508 0.0254"/>
      </geometry>
      <material name="leg_orange"/>
    </visual>
    <collision>
      <origin rpy="0 0 0" xyz="0 0.0254 0"/>
      <geometry>
        <box size="0.0254 0.0508 0.0254"/>
      </geometry>
    </collision>
    <inertial>
      <origin rpy="0 0 0" xyz="0 0.0254 0"/>
      <mass value="0.03"/>
      <inertia ixx="8.064499999999999e-06" ixy="0" ixz="0" iyy="3.2258e-06" iyz="0" izz="8.064499999999999e-06"/>
    </inertial>
  </link>
  <!-- JOINT 3 -->
  <joint name="joint3_leg0" type="revolute">
    <parent link="leg0_link1"/>
    <child link="leg0_link2"/>
    <origin rpy="0 0 0" xyz="0 0.0508 0"/>
    <axis xyz="1 0 0"/>
    <limit effort="2.0" lower="-1.5707963267948966" upper="1.5707963267948966" velocity="3.0"/>
  </joint>
  <!-- LINK 2 -->
  <link name="leg0_link2">
    <visual>
      <origin rpy="0 0 0" xyz="0 0 -0.03175"/>
      <geometry>
        <box size="0.0254 0.0254 0.0635"/>
      </geometry>
      <material name="leg_orange"/>
    </visual>
    <collision>
      <origin rpy="0 0 0" xyz="0 0 -0.03175"/>
      <geometry>
        <box size="0.0254 0.0254 0.0635"/>
      </geometry>
    </collision>
    <inertial>
      <origin rpy="0 0 0" xyz="0 0 -0.03175"/>
      <mass value="0.03"/>
      <inertia ixx="1.1693524999999999e-05" ixy="0" ixz="0" iyy="1.1693524999999999e-05" iyz="0" izz="3.2258e-06"/>
    </inertial>
  </link>
  <!-- JOINT 4 -->
  <joint name="joint4_leg0" type="revolute">
    <parent link="leg0_link2"/>
    <child link="leg0_link3"/>
    <origin rpy="0 0 0" xyz="0 0 -0.0635"/>
    <axis xyz="1 0 0"/>
    <limit effort="2.0" lower="-1.5707963267948966" upper="1.5707963267948966" velocity="3.0"/>
  </joint>
  <!-- LINK 3 -->
  <link name="leg0_link3">
    <visual>
      <origin rpy="0 0 0" xyz="0 0 -0.0254"/>
      <geometry>
        <box size="0.0254 0.0254 0.0508"/>
      </geometry>
      <material name="leg_orange"/>
    </visual>
    <collision>
      <origin rpy="0 0 0" xyz="0 0 -0.0254"/>
      <geometry>
        <box size="0.0254 0.0254 0.0508"/>
      </geometry>
    </collision>
    <inertial>
      <origin rpy="0 0 0" xyz="0 0 -0.0254"/>
      <mass value="0.03"/>
      <inertia ixx="8.064499999999999e-06" ixy="0" ixz="0" iyy="8.064499999999999e-06" iyz="0" izz="3.2258e-06"/>
    </inertial>
  </link>
  <!-- FOOT -->
  <joint name="leg0_foot_fixed" type="fixed">
    <parent link="leg0_link3"/>
    <child link="leg0_foot"/>
    <origin rpy="0 0 0" xyz="0 0 -0.0508"/>
  </joint>
  <link name="leg0_foot">
    <visual>
      <origin rpy="0 0 0" xyz="0 0 0.0127"/>
      <geometry>
        <sphere radius="0.0127"/>
      </geometry>
      <material name="foot_black"/>
    </visual>
    <collision>
      <origin rpy="0 0 0" xyz="0 0 0.0127"/>
      <geometry>
        <sphere radius="0.0127"/>
      </geometry>
    </collision>
    <inertial>
      <origin rpy="0 0 0" xyz="0 0 0.0127"/>
      <mass value="0.01"/>
      <inertia ixx="6.4516e-07" ixy="0" ixz="0" iyy="6.4516e-07" iyz="0" izz="6.4516e-07"/>
    </inertial>
  </link>
  <!-- 1 FRONT RIGHT -->
  <!-- JOINT 1 -->
  <joint name="joint1_leg1" type="revolute">
    <parent link="base_link"/>
    <child link="leg1_link1"/>
    <origin rpy="0 0 0" xyz="0.07619999999999999 -0.07619999999999999 0"/>
    <axis xyz="0 0 1"/>
    <limit effort="2.0" lower="-1.5707963267948966" upper="1.5707963267948966" velocity="3.0"/>
  </joint>
  <!-- LINK 1 -->
  <link name="leg1_link1">
    <visual>
      <origin rpy="0 0 0" xyz="0 -0.0254 0"/>
      <geometry>
        <box size="0.0254 0.0508 0.0254"/>
      </geometry>
      <material name="leg_orange"/>
    </visual>
    <collision>
      <origin rpy="0 0 0" xyz="0 -0.0254 0"/>
      <geometry>
        <box size="0.0254 0.0508 0.0254"/>
      </geometry>
    </collision>
    <inertial>
      <origin rpy="0 0 0" xyz="0 -0.0254 0"/>
      <mass value="0.03"/>
      <inertia ixx="8.064499999999999e-06" ixy="0" ixz="0" iyy="3.2258e-06" iyz="0" izz="8.064499999999999e-06"/>
    </inertial>
  </link>
  <!-- JOINT 3 -->
  <joint name="joint3_leg1" type="revolute">
    <parent link="leg1_link1"/>
    <child link="leg1_link2"/>
    <origin rpy="0 0 0" xyz="0 -0.0508 0"/>
    <axis xyz="1 0 0"/>
    <limit effort="2.0" lower="-1.5707963267948966" upper="1.5707963267948966" velocity="3.0"/>
  </joint>
  <!-- LINK 2 -->
  <link name="leg1_link2">
    <visual>
      <origin rpy="0 0 0" xyz="0 0 -0.03175"/>
      <geometry>
        <box size="0.0254 0.0254 0.0635"/>
      </geometry>
      <material name="leg_orange"/>
    </visual>
    <collision>
      <origin rpy="0 0 0" xyz="0 0 -0.03175"/>
      <geometry>
        <box size="0.0254 0.0254 0.0635"/>
      </geometry>
    </collision>
    <inertial>
      <origin rpy="0 0 0" xyz="0 0 -0.03175"/>
      <mass value="0.03"/>
      <inertia ixx="1.1693524999999999e-05" ixy="0" ixz="0" iyy="1.1693524999999999e-05" iyz="0" izz="3.2258e-06"/>
    </inertial>
  </link>
  <!-- JOINT 4 -->
  <joint name="joint4_leg1" type="revolute">
    <parent link="leg1_link2"/>
    <child link="leg1_link3"/>
    <origin rpy="0 0 0" xyz="0 0 -0.0635"/>
    <axis xyz="1 0 0"/>
    <limit effort="2.0" lower="-1.5707963267948966" upper="1.5707963267948966" velocity="3.0"/>
  </joint>
  <!-- LINK 3 -->
  <link name="leg1_link3">
    <visual>
      <origin rpy="0 0 0" xyz="0 0 -0.0254"/>
      <geometry>
        <box size="0.0254 0.0254 0.0508"/>
      </geometry>
      <material name="leg_orange"/>
    </visual>
    <collision>
      <origin rpy="0 0 0" xyz="0 0 -0.0254"/>
      <geometry>
        <box size="0.0254 0.0254 0.0508"/>
      </geometry>
    </collision>
    <inertial>
      <origin rpy="0 0 0" xyz="0 0 -0.0254"/>
      <mass value="0.03"/>
      <inertia ixx="8.064499999999999e-06" ixy="0" ixz="0" iyy="8.064499999999999e-06" iyz="0" izz="3.2258e-06"/>
    </inertial>
  </link>
  <!-- FOOT -->
  <joint name="leg1_foot_fixed" type="fixed">
    <parent link="leg1_link3"/>
    <child link="leg1_foot"/>
    <origin rpy="0 0 0" xyz="0 0 -0.0508"/>
  </joint>
  <link name="leg1_foot">
    <visual>
      <origin rpy="0 0 0" xyz="0 0 0.0127"/>
      <geometry>
        <sphere radius="0.0127"/>
      </geometry>
      <material name="foot_black"/>
    </visual>
    <collision>
      <origin rpy="0 0 0" xyz="0 0 0.0127"/>
      <geometry>
        <sphere radius="0.0127"/>
      </geometry>
    </collision>
    <inertial>
      <origin rpy="0 0 0" xyz="0 0 0.0127"/>
      <mass value="0.01"/>
      <inertia ixx="6.4516e-07" ixy="0" ixz="0" iyy="6.4516e-07" iyz="0" izz="6.4516e-07"/>
    </inertial>
  </link>
  <!-- 2 BACK LEFT -->
  <!-- JOINT 1 -->
  <joint name="joint1_leg2" type="revolute">
    <parent link="base_link"/>
    <child link="leg2_link1"/>
    <origin rpy="0 0 0" xyz="-0.07619999999999999 0.07619999999999999 0"/>
    <axis xyz="0 0 1"/>
    <limit effort="2.0" lower="-1.5707963267948966" upper="1.5707963267948966" velocity="3.0"/>
  </joint>
  <!-- LINK 1 -->
  <link name="leg2_link1">
    <visual>
      <origin rpy="0 0 0" xyz="0 0.0254 0"/>
      <geometry>
        <box size="0.0254 0.0508 0.0254"/>
      </geometry>
      <material name="leg_orange"/>
    </visual>
    <collision>
      <origin rpy="0 0 0" xyz="0 0.0254 0"/>
      <geometry>
        <box size="0.0254 0.0508 0.0254"/>
      </geometry>
    </collision>
    <inertial>
      <origin rpy="0 0 0" xyz="0 0.0254 0"/>
      <mass value="0.03"/>
      <inertia ixx="8.064499999999999e-06" ixy="0" ixz="0" iyy="3.2258e-06" iyz="0" izz="8.064499999999999e-06"/>
    </inertial>
  </link>
  <!-- JOINT 3 -->
  <joint name="joint3_leg2" type="revolute">
    <parent link="leg2_link1"/>
    <child link="leg2_link2"/>
    <origin rpy="0 0 0" xyz="0 0.0508 0"/>
    <axis xyz="1 0 0"/>
    <limit effort="2.0" lower="-1.5707963267948966" upper="1.5707963267948966" velocity="3.0"/>
  </joint>
  <!-- LINK 2 -->
  <link name="leg2_link2">
    <visual>
      <origin rpy="0 0 0" xyz="0 0 -0.03175"/>
      <geometry>
        <box size="0.0254 0.0254 0.0635"/>
      </geometry>
      <material name="leg_orange"/>
    </visual>
    <collision>
      <origin rpy="0 0 0" xyz="0 0 -0.03175"/>
      <geometry>
        <box size="0.0254 0.0254 0.0635"/>
      </geometry>
    </collision>
    <inertial>
      <origin rpy="0 0 0" xyz="0 0 -0.03175"/>
      <mass value="0.03"/>
      <inertia ixx="1.1693524999999999e-05" ixy="0" ixz="0" iyy="1.1693524999999999e-05" iyz="0" izz="3.2258e-06"/>
    </inertial>
  </link>
  <!-- JOINT 4 -->
  <joint name="joint4_leg2" type="revolute">
    <parent link="leg2_link2"/>
    <child link="leg2_link3"/>
    <origin rpy="0 0 0" xyz="0 0 -0.0635"/>
    <axis xyz="1 0 0"/>
    <limit effort="2.0" lower="-1.5707963267948966" upper="1.5707963267948966" velocity="3.0"/>
  </joint>
  <!-- LINK 3 -->
  <link name="leg2_link3">
    <visual>
      <origin rpy="0 0 0" xyz="0 0 -0.0254"/>
      <geometry>
        <box size="0.0254 0.0254 0.0508"/>
      </geometry>
      <material name="leg_orange"/>
    </visual>
    <collision>
      <origin rpy="0 0 0" xyz="0 0 -0.0254"/>
      <geometry>
        <box size="0.0254 0.0254 0.0508"/>
      </geometry>
    </collision>
    <inertial>
      <origin rpy="0 0 0" xyz="0 0 -0.0254"/>
      <mass value="0.03"/>
      <inertia ixx="8.064499999999999e-06" ixy="0" ixz="0" iyy="8.064499999999999e-06" iyz="0" izz="3.2258e-06"/>
    </inertial>
  </link>
  <!-- FOOT -->
  <joint name="leg2_foot_fixed" type="fixed">
    <parent link="leg2_link3"/>
    <child link="leg2_foot"/>
    <origin rpy="0 0 0" xyz="0 0 -0.0508"/>
  </joint>
  <link name="leg2_foot">
    <visual>
      <origin rpy="0 0 0" xyz="0 0 0.0127"/>
      <geometry>
        <sphere radius="0.0127"/>
      </geometry>
      <material name="foot_black"/>
    </visual>
    <collision>
      <origin rpy="0 0 0" xyz="0 0 0.0127"/>
      <geometry>
        <sphere radius="0.0127"/>
      </geometry>
    </collision>
    <inertial>
      <origin rpy="0 0 0" xyz="0 0 0.0127"/>
      <mass value="0.01"/>
      <inertia ixx="6.4516e-07" ixy="0" ixz="0" iyy="6.4516e-07" iyz="0" izz="6.4516e-07"/>
    </inertial>
  </link>
  <!-- 3 BACK RIGHT -->
  <!-- JOINT 1 -->
  <joint name="joint1_leg3" type="revolute">
    <parent link="base_link"/>
    <child link="leg3_link1"/>
    <origin rpy="0 0 0" xyz="-0.07619999999999999 -0.07619999999999999 0"/>
    <axis xyz="0 0 1"/>
    <limit effort="2.0" lower="-1.5707963267948966" upper="1.5707963267948966" velocity="3.0"/>
  </joint>
  <!-- LINK 1 -->
  <link name="leg3_link1">
    <visual>
      <origin rpy="0 0 0" xyz="0 -0.0254 0"/>
      <geometry>
        <box size="0.0254 0.0508 0.0254"/>
      </geometry>
      <material name="leg_orange"/>
    </visual>
    <collision>
      <origin rpy="0 0 0" xyz="0 -0.0254 0"/>
      <geometry>
        <box size="0.0254 0.0508 0.0254"/>
      </geometry>
    </collision>
    <inertial>
      <origin rpy="0 0 0" xyz="0 -0.0254 0"/>
      <mass value="0.03"/>
      <inertia ixx="8.064499999999999e-06" ixy="0" ixz="0" iyy="3.2258e-06" iyz="0" izz="8.064499999999999e-06"/>
    </inertial>
  </link>
  <!-- JOINT 3 -->
  <joint name="joint3_leg3" type="revolute">
    <parent link="leg3_link1"/>
    <child link="leg3_link2"/>
    <origin rpy="0 0 0" xyz="0 -0.0508 0"/>
    <axis xyz="1 0 0"/>
    <limit effort="2.0" lower="-1.5707963267948966" upper="1.5707963267948966" velocity="3.0"/>
  </joint>
  <!-- LINK 2 -->
  <link name="leg3_link2">
    <visual>
      <origin rpy="0 0 0" xyz="0 0 -0.03175"/>
      <geometry>
        <box size="0.0254 0.0254 0.0635"/>
      </geometry>
      <material name="leg_orange"/>
    </visual>
    <collision>
      <origin rpy="0 0 0" xyz="0 0 -0.03175"/>
      <geometry>
        <box size="0.0254 0.0254 0.0635"/>
      </geometry>
    </collision>
    <inertial>
      <origin rpy="0 0 0" xyz="0 0 -0.03175"/>
      <mass value="0.03"/>
      <inertia ixx="1.1693524999999999e-05" ixy="0" ixz="0" iyy="1.1693524999999999e-05" iyz="0" izz="3.2258e-06"/>
    </inertial>
  </link>
  <!-- JOINT 4 -->
  <joint name="joint4_leg3" type="revolute">
    <parent link="leg3_link2"/>
    <child link="leg3_link3"/>
    <origin rpy="0 0 0" xyz="0 0 -0.0635"/>
    <axis xyz="1 0 0"/>
    <limit effort="2.0" lower="-1.5707963267948966" upper="1.5707963267948966" velocity="3.0"/>
  </joint>
  <!-- LINK 3 -->
  <link name="leg3_link3">
    <visual>
      <origin rpy="0 0 0" xyz="0 0 -0.0254"/>
      <geometry>
        <box size="0.0254 0.0254 0.0508"/>
      </geometry>
      <material name="leg_orange"/>
    </visual>
    <collision>
      <origin rpy="0 0 0" xyz="0 0 -0.0254"/>
      <geometry>
        <box size="0.0254 0.0254 0.0508"/>
      </geometry>
    </collision>
    <inertial>
      <origin rpy="0 0 0" xyz="0 0 -0.0254"/>
      <mass value="0.03"/>
      <inertia ixx="8.064499999999999e-06" ixy="0" ixz="0" iyy="8.064499999999999e-06" iyz="0" izz="3.2258e-06"/>
    </inertial>
  </link>
  <!-- FOOT -->
  <joint name="leg3_foot_fixed" type="fixed">
    <parent link="leg3_link3"/>
    <child link="leg3_foot"/>
    <origin rpy="0 0 0" xyz="0 0 -0.0508"/>
  </joint>
  <link name="leg3_foot">
    <visual>
      <origin rpy="0 0 0" xyz="0 0 0.0127"/>
      <geometry>
        <sphere radius="0.0127"/>
      </geometry>
      <material name="foot_black"/>
    </visual>
    <collision>
      <origin rpy="0 0 0" xyz="0 0 0.0127"/>
      <geometry>
        <sphere radius="0.0127"/>
      </geometry>
    </collision>
    <inertial>
      <origin rpy="0 0 0" xyz="0 0 0.0127"/>
      <mass value="0.01"/>
      <inertia ixx="6.4516e-07" ixy="0" ixz="0" iyy="6.4516e-07" iyz="0" izz="6.4516e-07"/>
    </inertial>
  </link>
  <!-- WEBOTS PLUGIN -->
  <webots>
    <plugin type="webots_ros2_control::Ros2Control"/>
  </webots>
  <!-- CONTROLLED JOINT MACRO -->
  <!-- ROS2 CONTROL -->
  <ros2_control name="WebotsControl" type="system">
    <hardware>
      <plugin>webots_ros2_control::Ros2ControlSystem</plugin>
    </hardware>
    <!-- LEG 0 FL -->
    <joint name="joint1_leg0">
      <command_interface name="position">
        <param name="min">
          -1.5707963267948966
        </param>
        <param name="max">
          1.5707963267948966
        </param>
      </command_interface>
      <state_interface name="position"/>
      <state_interface name="velocity"/>
    </joint>
    <joint name="joint3_leg0">
      <command_interface name="position">
        <param name="min">
          -1.5707963267948966
        </param>
        <param name="max">
          1.5707963267948966
        </param>
      </command_interface>
      <state_interface name="position"/>
      <state_interface name="velocity"/>
    </joint>
    <joint name="joint4_leg0">
      <command_interface name="position">
        <param name="min">
          -1.5707963267948966
        </param>
        <param name="max">
          1.5707963267948966
        </param>
      </command_interface>
      <state_interface name="position"/>
      <state_interface name="velocity"/>
    </joint>
    <!-- LEG 1 FR -->
    <joint name="joint1_leg1">
      <command_interface name="position">
        <param name="min">
          -1.5707963267948966
        </param>
        <param name="max">
          1.5707963267948966
        </param>
      </command_interface>
      <state_interface name="position"/>
      <state_interface name="velocity"/>
    </joint>
    <joint name="joint3_leg1">
      <command_interface name="position">
        <param name="min">
          -1.5707963267948966
        </param>
        <param name="max">
          1.5707963267948966
        </param>
      </command_interface>
      <state_interface name="position"/>
      <state_interface name="velocity"/>
    </joint>
    <joint name="joint4_leg1">
      <command_interface name="position">
        <param name="min">
          -1.5707963267948966
        </param>
        <param name="max">
          1.5707963267948966
        </param>
      </command_interface>
      <state_interface name="position"/>
      <state_interface name="velocity"/>
    </joint>
    <!-- LEG 2 BL -->
    <joint name="joint1_leg2">
      <command_interface name="position">
        <param name="min">
          -1.5707963267948966
        </param>
        <param name="max">
          1.5707963267948966
        </param>
      </command_interface>
      <state_interface name="position"/>
      <state_interface name="velocity"/>
    </joint>
    <joint name="joint3_leg2">
      <command_interface name="position">
        <param name="min">
          -1.5707963267948966
        </param>
        <param name="max">
          1.5707963267948966
        </param>
      </command_interface>
      <state_interface name="position"/>
      <state_interface name="velocity"/>
    </joint>
    <joint name="joint4_leg2">
      <command_interface name="position">
        <param name="min">
          -1.5707963267948966
        </param>
        <param name="max">
          1.5707963267948966
        </param>
      </command_interface>
      <state_interface name="position"/>
      <state_interface name="velocity"/>
    </joint>
    <!-- LEG 3 BR -->
    <joint name="joint1_leg3">
      <command_interface name="position">
        <param name="min">
          -1.5707963267948966
        </param>
        <param name="max">
          1.5707963267948966
        </param>
      </command_interface>
      <state_interface name="position"/>
      <state_interface name="velocity"/>
    </joint>
    <joint name="joint3_leg3">
      <command_interface name="position">
        <param name="min">
          -1.5707963267948966
        </param>
        <param name="max">
          1.5707963267948966
        </param>
      </command_interface>
      <state_interface name="position"/>
      <state_interface name="velocity"/>
    </joint>
    <joint name="joint4_leg3">
      <command_interface name="position">
        <param name="min">
          -1.5707963267948966
        </param>
        <param name="max">
          1.5707963267948966
        </param>
      </command_interface>
      <state_interface name="position"/>
      <state_interface name="velocity"/>
    </joint>
  </ros2_control>
</robot>
