Arkrez/bob/cad/rocky_bob/sim/rocky_bob.urdf

<?xml version="1.0"?>
<!-- Generated by build.py: Rocky-Bob, rock body + 4 legs, HobbyPark 25 kg coreless servos. -->
<robot name="rocky_bob">
  <link name="base_link">
    <visual><geometry><mesh filename="meshes/rock_base.stl"/></geometry><material name="rock_base"><color rgba="0.47 0.42 0.37 1"/></material></visual>
    <visual><geometry><mesh filename="meshes/rock_lid.stl"/></geometry><material name="rock_lid"><color rgba="0.6 0.55 0.48 1"/></material></visual>
    <visual><geometry><mesh filename="meshes/pi5.stl"/></geometry><material name="pi5"><color rgba="0.1 0.45 0.2 1"/></material></visual>
    <visual><geometry><mesh filename="meshes/servo2040.stl"/></geometry><material name="servo2040"><color rgba="0.08 0.08 0.1 1"/></material></visual>
    <visual><geometry><mesh filename="meshes/psu.stl"/></geometry><material name="psu"><color rgba="0.25 0.35 0.6 1"/></material></visual>
    <visual><geometry><mesh filename="meshes/pi_camera.stl"/></geometry><material name="pi_camera"><color rgba="0.1 0.45 0.2 1"/></material></visual>
    <visual><geometry><mesh filename="meshes/mustache.stl"/></geometry><material name="mustache"><color rgba="0.1 0.07 0.05 1"/></material></visual>
    <visual><geometry><mesh filename="meshes/tof.stl"/></geometry><material name="tof"><color rgba="0.75 0.12 0.1 1"/></material></visual>
    <visual><geometry><mesh filename="meshes/lidar.stl"/></geometry><material name="lidar"><color rgba="0.08 0.08 0.1 1"/></material></visual>
    <collision><origin xyz="0.00000 0.00000 0.00000" rpy="0 0 0"/><geometry><mesh filename="meshes/rock_collision.stl"/></geometry></collision>
    <collision><origin xyz="0.00000 0.00000 0.12500" rpy="0 0 0"/><geometry><box size="0.06400 0.06400 0.02600"/></geometry></collision>
    <collision name="lidar"><origin xyz="0.00000 0.00000 0.15665" rpy="0 0 0"/><geometry><box size="0.05560 0.05560 0.04130"/></geometry></collision>
    <inertial><origin xyz="-0.01452 -0.00155 0.05871"/><mass value="0.7748"/><inertia ixx="3.716e-03" iyy="4.421e-03" izz="3.801e-03" ixy="5.903e-05" ixz="-4.213e-04" iyz="-3.749e-05"/></inertial>
  </link>
  <link name="leg0_mount">
    <visual><geometry><mesh filename="meshes/hip_pod.stl"/></geometry><material name="hip_pod"><color rgba="0.34 0.31 0.28 1"/></material></visual>
    <visual><geometry><mesh filename="meshes/servo_hip_yaw.stl"/></geometry><material name="servo_hip_yaw"><color rgba="0.1 0.1 0.12 1"/></material></visual>
    <collision><origin xyz="-0.02000 0.00000 -0.01000" rpy="0 0 0"/><geometry><box size="0.06500 0.04500 0.05600"/></geometry></collision>
    <inertial><origin xyz="-0.01176 -0.00010 -0.00481"/><mass value="0.0812"/><inertia ixx="1.511e-05" iyy="3.120e-05" izz="2.395e-05" ixy="-2.071e-07" ixz="-7.322e-07" iyz="-1.066e-07"/></inertial>
  </link>
  <link name="leg0_joint1_link">
    <visual><geometry><mesh filename="meshes/horn_hip_yaw.stl"/></geometry><material name="horn_hip_yaw"><color rgba="0.85 0.85 0.85 1"/></material></visual>
    <visual><geometry><mesh filename="meshes/coxa.stl"/></geometry><material name="coxa"><color rgba="0.34 0.31 0.28 1"/></material></visual>
    <visual><geometry><mesh filename="meshes/servo_hip_pitch.stl"/></geometry><material name="servo_hip_pitch"><color rgba="0.1 0.1 0.12 1"/></material></visual>
    <collision><origin xyz="0.06500 -0.01000 0.00000" rpy="0 0 0"/><geometry><box size="0.13000 0.05500 0.04000"/></geometry></collision>
    <inertial><origin xyz="0.07389 -0.00425 -0.00052"/><mass value="0.1366"/><inertia ixx="4.373e-05" iyy="1.538e-04" izz="1.468e-04" ixy="1.743e-06" ixz="-2.983e-06" iyz="6.516e-07"/></inertial>
  </link>
  <link name="leg0_joint2_link">
    <visual><geometry><mesh filename="meshes/horn_hip_pitch.stl"/></geometry><material name="horn_hip_pitch"><color rgba="0.85 0.85 0.85 1"/></material></visual>
    <visual><geometry><mesh filename="meshes/femur.stl"/></geometry><material name="femur"><color rgba="0.47 0.42 0.37 1"/></material></visual>
    <visual><geometry><mesh filename="meshes/servo_knee.stl"/></geometry><material name="servo_knee"><color rgba="0.1 0.1 0.12 1"/></material></visual>
    <collision><origin xyz="0.08460 -0.01050 0.00000" rpy="0 1.5708 0"/><geometry><cylinder radius="0.02400" length="0.10920"/></geometry></collision>
    <inertial><origin xyz="0.07952 -0.00478 0.00039"/><mass value="0.1454"/><inertia ixx="4.145e-05" iyy="1.639e-04" izz="1.808e-04" ixy="6.618e-06" ixz="1.768e-08" iyz="4.740e-07"/></inertial>
  </link>
  <link name="leg0_joint3_link">
    <visual><geometry><mesh filename="meshes/horn_knee.stl"/></geometry><material name="horn_knee"><color rgba="0.85 0.85 0.85 1"/></material></visual>
    <visual><geometry><mesh filename="meshes/tibia.stl"/></geometry><material name="tibia"><color rgba="0.47 0.42 0.37 1"/></material></visual>
    <visual><geometry><mesh filename="meshes/foot.stl"/></geometry><material name="foot"><color rgba="0.6 0.55 0.48 1"/></material></visual>
    <collision><origin xyz="0.09200 -0.00175 0.00000" rpy="0 1.5708 0"/><geometry><cylinder radius="0.01300" length="0.10400"/></geometry></collision>
    <collision><origin xyz="0.16000 -0.00175 0.00000" rpy="0 0 0"/><geometry><sphere radius="0.01600"/></geometry></collision>
    <inertial><origin xyz="0.07456 -0.00185 -0.00008"/><mass value="0.0729"/><inertia ixx="2.362e-05" iyy="1.538e-04" izz="1.675e-04" ixy="-3.409e-07" ixz="4.865e-07" iyz="-2.598e-08"/></inertial>
  </link>
  <joint name="leg0_mount_fixed" type="fixed"><parent link="base_link"/><child link="leg0_mount"/><origin xyz="-0.10624 -0.10624 0.06000" rpy="0 0 3.926991"/></joint>
  <joint name="joint1_leg0" type="revolute"><parent link="leg0_mount"/><child link="leg0_joint1_link"/><origin xyz="0.00000 0.00000 0.00000"/><axis xyz="0 0 1"/><limit lower="-1.5708" upper="1.5708" effort="2.45" velocity="8.0"/></joint>
  <joint name="joint3_leg0" type="revolute"><parent link="leg0_joint1_link"/><child link="leg0_joint2_link"/><origin xyz="0.10720 0.00000 0.00000"/><axis xyz="0 1 0"/><limit lower="-1.5708" upper="1.5708" effort="2.45" velocity="8.0"/></joint>
  <joint name="joint4_leg0" type="revolute"><parent link="leg0_joint2_link"/><child link="leg0_joint3_link"/><origin xyz="0.10720 0.00000 0.00000"/><axis xyz="0 1 0"/><limit lower="-1.5708" upper="1.5708" effort="2.45" velocity="8.0"/></joint>
  <link name="leg0_foot"/>
  <joint name="leg0_foot_fixed" type="fixed"><parent link="leg0_joint3_link"/><child link="leg0_foot"/><origin xyz="0.16000 -0.00175 0"/></joint>
  <link name="leg1_mount">
    <visual><geometry><mesh filename="meshes/hip_pod.stl"/></geometry><material name="hip_pod"><color rgba="0.34 0.31 0.28 1"/></material></visual>
    <visual><geometry><mesh filename="meshes/servo_hip_yaw.stl"/></geometry><material name="servo_hip_yaw"><color rgba="0.1 0.1 0.12 1"/></material></visual>
    <collision><origin xyz="-0.02000 0.00000 -0.01000" rpy="0 0 0"/><geometry><box size="0.06500 0.04500 0.05600"/></geometry></collision>
    <inertial><origin xyz="-0.01176 -0.00010 -0.00481"/><mass value="0.0812"/><inertia ixx="1.511e-05" iyy="3.120e-05" izz="2.395e-05" ixy="-2.071e-07" ixz="-7.322e-07" iyz="-1.066e-07"/></inertial>
  </link>
  <link name="leg1_joint1_link">
    <visual><geometry><mesh filename="meshes/horn_hip_yaw.stl"/></geometry><material name="horn_hip_yaw"><color rgba="0.85 0.85 0.85 1"/></material></visual>
    <visual><geometry><mesh filename="meshes/coxa.stl"/></geometry><material name="coxa"><color rgba="0.34 0.31 0.28 1"/></material></visual>
    <visual><geometry><mesh filename="meshes/servo_hip_pitch.stl"/></geometry><material name="servo_hip_pitch"><color rgba="0.1 0.1 0.12 1"/></material></visual>
    <collision><origin xyz="0.06500 -0.01000 0.00000" rpy="0 0 0"/><geometry><box size="0.13000 0.05500 0.04000"/></geometry></collision>
    <inertial><origin xyz="0.07389 -0.00425 -0.00052"/><mass value="0.1366"/><inertia ixx="4.373e-05" iyy="1.538e-04" izz="1.468e-04" ixy="1.743e-06" ixz="-2.983e-06" iyz="6.516e-07"/></inertial>
  </link>
  <link name="leg1_joint2_link">
    <visual><geometry><mesh filename="meshes/horn_hip_pitch.stl"/></geometry><material name="horn_hip_pitch"><color rgba="0.85 0.85 0.85 1"/></material></visual>
    <visual><geometry><mesh filename="meshes/femur.stl"/></geometry><material name="femur"><color rgba="0.47 0.42 0.37 1"/></material></visual>
    <visual><geometry><mesh filename="meshes/servo_knee.stl"/></geometry><material name="servo_knee"><color rgba="0.1 0.1 0.12 1"/></material></visual>
    <collision><origin xyz="0.08460 -0.01050 0.00000" rpy="0 1.5708 0"/><geometry><cylinder radius="0.02400" length="0.10920"/></geometry></collision>
    <inertial><origin xyz="0.07952 -0.00478 0.00039"/><mass value="0.1454"/><inertia ixx="4.145e-05" iyy="1.639e-04" izz="1.808e-04" ixy="6.618e-06" ixz="1.768e-08" iyz="4.740e-07"/></inertial>
  </link>
  <link name="leg1_joint3_link">
    <visual><geometry><mesh filename="meshes/horn_knee.stl"/></geometry><material name="horn_knee"><color rgba="0.85 0.85 0.85 1"/></material></visual>
    <visual><geometry><mesh filename="meshes/tibia.stl"/></geometry><material name="tibia"><color rgba="0.47 0.42 0.37 1"/></material></visual>
    <visual><geometry><mesh filename="meshes/foot.stl"/></geometry><material name="foot"><color rgba="0.6 0.55 0.48 1"/></material></visual>
    <collision><origin xyz="0.09200 -0.00175 0.00000" rpy="0 1.5708 0"/><geometry><cylinder radius="0.01300" length="0.10400"/></geometry></collision>
    <collision><origin xyz="0.16000 -0.00175 0.00000" rpy="0 0 0"/><geometry><sphere radius="0.01600"/></geometry></collision>
    <inertial><origin xyz="0.07456 -0.00185 -0.00008"/><mass value="0.0729"/><inertia ixx="2.362e-05" iyy="1.538e-04" izz="1.675e-04" ixy="-3.409e-07" ixz="4.865e-07" iyz="-2.598e-08"/></inertial>
  </link>
  <joint name="leg1_mount_fixed" type="fixed"><parent link="base_link"/><child link="leg1_mount"/><origin xyz="-0.10624 0.10624 0.06000" rpy="0 0 2.356194"/></joint>
  <joint name="joint1_leg1" type="revolute"><parent link="leg1_mount"/><child link="leg1_joint1_link"/><origin xyz="0.00000 0.00000 0.00000"/><axis xyz="0 0 1"/><limit lower="-1.5708" upper="1.5708" effort="2.45" velocity="8.0"/></joint>
  <joint name="joint3_leg1" type="revolute"><parent link="leg1_joint1_link"/><child link="leg1_joint2_link"/><origin xyz="0.10720 0.00000 0.00000"/><axis xyz="0 1 0"/><limit lower="-1.5708" upper="1.5708" effort="2.45" velocity="8.0"/></joint>
  <joint name="joint4_leg1" type="revolute"><parent link="leg1_joint2_link"/><child link="leg1_joint3_link"/><origin xyz="0.10720 0.00000 0.00000"/><axis xyz="0 1 0"/><limit lower="-1.5708" upper="1.5708" effort="2.45" velocity="8.0"/></joint>
  <link name="leg1_foot"/>
  <joint name="leg1_foot_fixed" type="fixed"><parent link="leg1_joint3_link"/><child link="leg1_foot"/><origin xyz="0.16000 -0.00175 0"/></joint>
  <link name="leg2_mount">
    <visual><geometry><mesh filename="meshes/hip_pod.stl"/></geometry><material name="hip_pod"><color rgba="0.34 0.31 0.28 1"/></material></visual>
    <visual><geometry><mesh filename="meshes/servo_hip_yaw.stl"/></geometry><material name="servo_hip_yaw"><color rgba="0.1 0.1 0.12 1"/></material></visual>
    <collision><origin xyz="-0.02000 0.00000 -0.01000" rpy="0 0 0"/><geometry><box size="0.06500 0.04500 0.05600"/></geometry></collision>
    <inertial><origin xyz="-0.01176 -0.00010 -0.00481"/><mass value="0.0812"/><inertia ixx="1.511e-05" iyy="3.120e-05" izz="2.395e-05" ixy="-2.071e-07" ixz="-7.322e-07" iyz="-1.066e-07"/></inertial>
  </link>
  <link name="leg2_joint1_link">
    <visual><geometry><mesh filename="meshes/horn_hip_yaw.stl"/></geometry><material name="horn_hip_yaw"><color rgba="0.85 0.85 0.85 1"/></material></visual>
    <visual><geometry><mesh filename="meshes/coxa.stl"/></geometry><material name="coxa"><color rgba="0.34 0.31 0.28 1"/></material></visual>
    <visual><geometry><mesh filename="meshes/servo_hip_pitch.stl"/></geometry><material name="servo_hip_pitch"><color rgba="0.1 0.1 0.12 1"/></material></visual>
    <collision><origin xyz="0.06500 -0.01000 0.00000" rpy="0 0 0"/><geometry><box size="0.13000 0.05500 0.04000"/></geometry></collision>
    <inertial><origin xyz="0.07389 -0.00425 -0.00052"/><mass value="0.1366"/><inertia ixx="4.373e-05" iyy="1.538e-04" izz="1.468e-04" ixy="1.743e-06" ixz="-2.983e-06" iyz="6.516e-07"/></inertial>
  </link>
  <link name="leg2_joint2_link">
    <visual><geometry><mesh filename="meshes/horn_hip_pitch.stl"/></geometry><material name="horn_hip_pitch"><color rgba="0.85 0.85 0.85 1"/></material></visual>
    <visual><geometry><mesh filename="meshes/femur.stl"/></geometry><material name="femur"><color rgba="0.47 0.42 0.37 1"/></material></visual>
    <visual><geometry><mesh filename="meshes/servo_knee.stl"/></geometry><material name="servo_knee"><color rgba="0.1 0.1 0.12 1"/></material></visual>
    <collision><origin xyz="0.08460 -0.01050 0.00000" rpy="0 1.5708 0"/><geometry><cylinder radius="0.02400" length="0.10920"/></geometry></collision>
    <inertial><origin xyz="0.07952 -0.00478 0.00039"/><mass value="0.1454"/><inertia ixx="4.145e-05" iyy="1.639e-04" izz="1.808e-04" ixy="6.618e-06" ixz="1.768e-08" iyz="4.740e-07"/></inertial>
  </link>
  <link name="leg2_joint3_link">
    <visual><geometry><mesh filename="meshes/horn_knee.stl"/></geometry><material name="horn_knee"><color rgba="0.85 0.85 0.85 1"/></material></visual>
    <visual><geometry><mesh filename="meshes/tibia.stl"/></geometry><material name="tibia"><color rgba="0.47 0.42 0.37 1"/></material></visual>
    <visual><geometry><mesh filename="meshes/foot.stl"/></geometry><material name="foot"><color rgba="0.6 0.55 0.48 1"/></material></visual>
    <collision><origin xyz="0.09200 -0.00175 0.00000" rpy="0 1.5708 0"/><geometry><cylinder radius="0.01300" length="0.10400"/></geometry></collision>
    <collision><origin xyz="0.16000 -0.00175 0.00000" rpy="0 0 0"/><geometry><sphere radius="0.01600"/></geometry></collision>
    <inertial><origin xyz="0.07456 -0.00185 -0.00008"/><mass value="0.0729"/><inertia ixx="2.362e-05" iyy="1.538e-04" izz="1.675e-04" ixy="-3.409e-07" ixz="4.865e-07" iyz="-2.598e-08"/></inertial>
  </link>
  <joint name="leg2_mount_fixed" type="fixed"><parent link="base_link"/><child link="leg2_mount"/><origin xyz="0.10624 0.10624 0.06000" rpy="0 0 0.785398"/></joint>
  <joint name="joint1_leg2" type="revolute"><parent link="leg2_mount"/><child link="leg2_joint1_link"/><origin xyz="0.00000 0.00000 0.00000"/><axis xyz="0 0 1"/><limit lower="-1.5708" upper="1.5708" effort="2.45" velocity="8.0"/></joint>
  <joint name="joint3_leg2" type="revolute"><parent link="leg2_joint1_link"/><child link="leg2_joint2_link"/><origin xyz="0.10720 0.00000 0.00000"/><axis xyz="0 1 0"/><limit lower="-1.5708" upper="1.5708" effort="2.45" velocity="8.0"/></joint>
  <joint name="joint4_leg2" type="revolute"><parent link="leg2_joint2_link"/><child link="leg2_joint3_link"/><origin xyz="0.10720 0.00000 0.00000"/><axis xyz="0 1 0"/><limit lower="-1.5708" upper="1.5708" effort="2.45" velocity="8.0"/></joint>
  <link name="leg2_foot"/>
  <joint name="leg2_foot_fixed" type="fixed"><parent link="leg2_joint3_link"/><child link="leg2_foot"/><origin xyz="0.16000 -0.00175 0"/></joint>
  <link name="leg3_mount">
    <visual><geometry><mesh filename="meshes/hip_pod.stl"/></geometry><material name="hip_pod"><color rgba="0.34 0.31 0.28 1"/></material></visual>
    <visual><geometry><mesh filename="meshes/servo_hip_yaw.stl"/></geometry><material name="servo_hip_yaw"><color rgba="0.1 0.1 0.12 1"/></material></visual>
    <collision><origin xyz="-0.02000 0.00000 -0.01000" rpy="0 0 0"/><geometry><box size="0.06500 0.04500 0.05600"/></geometry></collision>
    <inertial><origin xyz="-0.01176 -0.00010 -0.00481"/><mass value="0.0812"/><inertia ixx="1.511e-05" iyy="3.120e-05" izz="2.395e-05" ixy="-2.071e-07" ixz="-7.322e-07" iyz="-1.066e-07"/></inertial>
  </link>
  <link name="leg3_joint1_link">
    <visual><geometry><mesh filename="meshes/horn_hip_yaw.stl"/></geometry><material name="horn_hip_yaw"><color rgba="0.85 0.85 0.85 1"/></material></visual>
    <visual><geometry><mesh filename="meshes/coxa.stl"/></geometry><material name="coxa"><color rgba="0.34 0.31 0.28 1"/></material></visual>
    <visual><geometry><mesh filename="meshes/servo_hip_pitch.stl"/></geometry><material name="servo_hip_pitch"><color rgba="0.1 0.1 0.12 1"/></material></visual>
    <collision><origin xyz="0.06500 -0.01000 0.00000" rpy="0 0 0"/><geometry><box size="0.13000 0.05500 0.04000"/></geometry></collision>
    <inertial><origin xyz="0.07389 -0.00425 -0.00052"/><mass value="0.1366"/><inertia ixx="4.373e-05" iyy="1.538e-04" izz="1.468e-04" ixy="1.743e-06" ixz="-2.983e-06" iyz="6.516e-07"/></inertial>
  </link>
  <link name="leg3_joint2_link">
    <visual><geometry><mesh filename="meshes/horn_hip_pitch.stl"/></geometry><material name="horn_hip_pitch"><color rgba="0.85 0.85 0.85 1"/></material></visual>
    <visual><geometry><mesh filename="meshes/femur.stl"/></geometry><material name="femur"><color rgba="0.47 0.42 0.37 1"/></material></visual>
    <visual><geometry><mesh filename="meshes/servo_knee.stl"/></geometry><material name="servo_knee"><color rgba="0.1 0.1 0.12 1"/></material></visual>
    <collision><origin xyz="0.08460 -0.01050 0.00000" rpy="0 1.5708 0"/><geometry><cylinder radius="0.02400" length="0.10920"/></geometry></collision>
    <inertial><origin xyz="0.07952 -0.00478 0.00039"/><mass value="0.1454"/><inertia ixx="4.145e-05" iyy="1.639e-04" izz="1.808e-04" ixy="6.618e-06" ixz="1.768e-08" iyz="4.740e-07"/></inertial>
  </link>
  <link name="leg3_joint3_link">
    <visual><geometry><mesh filename="meshes/horn_knee.stl"/></geometry><material name="horn_knee"><color rgba="0.85 0.85 0.85 1"/></material></visual>
    <visual><geometry><mesh filename="meshes/tibia.stl"/></geometry><material name="tibia"><color rgba="0.47 0.42 0.37 1"/></material></visual>
    <visual><geometry><mesh filename="meshes/foot.stl"/></geometry><material name="foot"><color rgba="0.6 0.55 0.48 1"/></material></visual>
    <collision><origin xyz="0.09200 -0.00175 0.00000" rpy="0 1.5708 0"/><geometry><cylinder radius="0.01300" length="0.10400"/></geometry></collision>
    <collision><origin xyz="0.16000 -0.00175 0.00000" rpy="0 0 0"/><geometry><sphere radius="0.01600"/></geometry></collision>
    <inertial><origin xyz="0.07456 -0.00185 -0.00008"/><mass value="0.0729"/><inertia ixx="2.362e-05" iyy="1.538e-04" izz="1.675e-04" ixy="-3.409e-07" ixz="4.865e-07" iyz="-2.598e-08"/></inertial>
  </link>
  <joint name="leg3_mount_fixed" type="fixed"><parent link="base_link"/><child link="leg3_mount"/><origin xyz="0.10624 -0.10624 0.06000" rpy="0 0 -0.785398"/></joint>
  <joint name="joint1_leg3" type="revolute"><parent link="leg3_mount"/><child link="leg3_joint1_link"/><origin xyz="0.00000 0.00000 0.00000"/><axis xyz="0 0 1"/><limit lower="-1.5708" upper="1.5708" effort="2.45" velocity="8.0"/></joint>
  <joint name="joint3_leg3" type="revolute"><parent link="leg3_joint1_link"/><child link="leg3_joint2_link"/><origin xyz="0.10720 0.00000 0.00000"/><axis xyz="0 1 0"/><limit lower="-1.5708" upper="1.5708" effort="2.45" velocity="8.0"/></joint>
  <joint name="joint4_leg3" type="revolute"><parent link="leg3_joint2_link"/><child link="leg3_joint3_link"/><origin xyz="0.10720 0.00000 0.00000"/><axis xyz="0 1 0"/><limit lower="-1.5708" upper="1.5708" effort="2.45" velocity="8.0"/></joint>
  <link name="leg3_foot"/>
  <joint name="leg3_foot_fixed" type="fixed"><parent link="leg3_joint3_link"/><child link="leg3_foot"/><origin xyz="0.16000 -0.00175 0"/></joint>
</robot>
