Arkrez/bob/src/bob_description/urdf/robot.urdf

<?xml version="1.0"?>
<robot name="bob">
  <link name="base_link"><visual><geometry><mesh filename="package://bob_description/meshes/base_link.stl"/></geometry></visual><inertial><mass value="1.0"/><inertia ixx="0.01" iyy="0.01" izz="0.01" ixy="0" ixz="0" iyz="0"/></inertial></link>
  <link name="leg0_mount"><visual><origin xyz="0 0 0" rpy="0 0 0"/><geometry><mesh filename="package://bob_description/meshes/leg0_part0.stl"/></geometry></visual><inertial><mass value="0.1"/><inertia ixx="0.001" iyy="0.001" izz="0.001" ixy="0" ixz="0" iyz="0"/></inertial></link>
  <joint name="leg0_mount_fixed" type="fixed"><parent link="base_link"/><child link="leg0_mount"/><origin xyz="0 0 0" rpy="0 0 0"/></joint>
  <link name="leg0_joint1_link"><visual><origin xyz="0.137775 0.086000 -0.111950" rpy="0 0 0"/><geometry><mesh filename="package://bob_description/meshes/leg0_part1.stl"/></geometry></visual><inertial><mass value="0.2"/><inertia ixx="0.001" iyy="0.001" izz="0.001" ixy="0" ixz="0" iyz="0"/></inertial></link>
  <joint name="joint1_leg0" type="revolute"><parent link="leg0_mount"/><child link="leg0_joint1_link"/><origin xyz="-0.137775 -0.086000 0.111950" rpy="0 0 0"/><axis xyz="0 0 1"/><limit lower="-1.570796" upper="1.570796" effort="10" velocity="2.618"/></joint>
  <link name="leg0_joint2_link"><visual><origin xyz="0.244985 0.060036 -0.101200" rpy="0 0 0"/><geometry><mesh filename="package://bob_description/meshes/leg0_part2.stl"/></geometry></visual><inertial><mass value="0.2"/><inertia ixx="0.001" iyy="0.001" izz="0.001" ixy="0" ixz="0" iyz="0"/></inertial></link>
  <joint name="joint3_leg0" type="revolute"><parent link="leg0_joint1_link"/><child link="leg0_joint2_link"/><origin xyz="-0.107210 0.025964 -0.010750" rpy="0 0 0"/><axis xyz="0 1 0"/><limit lower="-1.570796" upper="1.570796" effort="10" velocity="2.618"/></joint>
  <link name="leg0_joint3_link"><visual><origin xyz="0.352195 0.093736 -0.101186" rpy="0 0 0"/><geometry><mesh filename="package://bob_description/meshes/leg0_part3.stl"/></geometry></visual><inertial><mass value="0.2"/><inertia ixx="0.001" iyy="0.001" izz="0.001" ixy="0" ixz="0" iyz="0"/></inertial></link>
  <joint name="joint4_leg0" type="revolute"><parent link="leg0_joint2_link"/><child link="leg0_joint3_link"/><origin xyz="-0.107210 -0.033700 -0.000014" rpy="0 0 0"/><axis xyz="0 1 0"/><limit lower="-1.570796" upper="1.570796" effort="10" velocity="2.618"/></joint>
  <link name="leg1_mount"><visual><origin xyz="0 0 0" rpy="0 0 0"/><geometry><mesh filename="package://bob_description/meshes/leg1_part0.stl"/></geometry></visual><inertial><mass value="0.1"/><inertia ixx="0.001" iyy="0.001" izz="0.001" ixy="0" ixz="0" iyz="0"/></inertial></link>
  <joint name="leg1_mount_fixed" type="fixed"><parent link="base_link"/><child link="leg1_mount"/><origin xyz="0 0 0" rpy="0 0 0"/></joint>
  <link name="leg1_joint1_link"><visual><origin xyz="0.139700 -0.140000 -0.111950" rpy="0 0 0"/><geometry><mesh filename="package://bob_description/meshes/leg1_part1.stl"/></geometry></visual><inertial><mass value="0.2"/><inertia ixx="0.001" iyy="0.001" izz="0.001" ixy="0" ixz="0" iyz="0"/></inertial></link>
  <joint name="joint1_leg1" type="revolute"><parent link="leg1_mount"/><child link="leg1_joint1_link"/><origin xyz="-0.139700 0.140000 0.111950" rpy="0 0 0"/><axis xyz="0 0 1"/><limit lower="-1.570796" upper="1.570796" effort="10" velocity="2.618"/></joint>
  <link name="leg1_joint2_link"><visual><origin xyz="0.246910 -0.165964 -0.101200" rpy="0 0 0"/><geometry><mesh filename="package://bob_description/meshes/leg1_part2.stl"/></geometry></visual><inertial><mass value="0.2"/><inertia ixx="0.001" iyy="0.001" izz="0.001" ixy="0" ixz="0" iyz="0"/></inertial></link>
  <joint name="joint3_leg1" type="revolute"><parent link="leg1_joint1_link"/><child link="leg1_joint2_link"/><origin xyz="-0.107210 0.025964 -0.010750" rpy="0 0 0"/><axis xyz="0 1 0"/><limit lower="-1.570796" upper="1.570796" effort="10" velocity="2.618"/></joint>
  <link name="leg1_joint3_link"><visual><origin xyz="0.354120 -0.132264 -0.101186" rpy="0 0 0"/><geometry><mesh filename="package://bob_description/meshes/leg1_part3.stl"/></geometry></visual><inertial><mass value="0.2"/><inertia ixx="0.001" iyy="0.001" izz="0.001" ixy="0" ixz="0" iyz="0"/></inertial></link>
  <joint name="joint4_leg1" type="revolute"><parent link="leg1_joint2_link"/><child link="leg1_joint3_link"/><origin xyz="-0.107210 -0.033700 -0.000014" rpy="0 0 0"/><axis xyz="0 1 0"/><limit lower="-1.570796" upper="1.570796" effort="10" velocity="2.618"/></joint>
  <link name="leg2_mount"><visual><origin xyz="0 0 0" rpy="0 0 0"/><geometry><mesh filename="package://bob_description/meshes/leg2_part0.stl"/></geometry></visual><inertial><mass value="0.1"/><inertia ixx="0.001" iyy="0.001" izz="0.001" ixy="0" ixz="0" iyz="0"/></inertial></link>
  <joint name="leg2_mount_fixed" type="fixed"><parent link="base_link"/><child link="leg2_mount"/><origin xyz="0 0 0" rpy="0 0 0"/></joint>
  <link name="leg2_joint1_link"><visual><origin xyz="0.010300 -0.140000 -0.111950" rpy="0 0 0"/><geometry><mesh filename="package://bob_description/meshes/leg2_part1.stl"/></geometry></visual><inertial><mass value="0.2"/><inertia ixx="0.001" iyy="0.001" izz="0.001" ixy="0" ixz="0" iyz="0"/></inertial></link>
  <joint name="joint1_leg2" type="revolute"><parent link="leg2_mount"/><child link="leg2_joint1_link"/><origin xyz="-0.010300 0.140000 0.111950" rpy="0 0 0"/><axis xyz="0 0 1"/><limit lower="-1.570796" upper="1.570796" effort="10" velocity="2.618"/></joint>
  <link name="leg2_joint2_link"><visual><origin xyz="-0.096910 -0.114036 -0.101200" rpy="0 0 0"/><geometry><mesh filename="package://bob_description/meshes/leg2_part2.stl"/></geometry></visual><inertial><mass value="0.2"/><inertia ixx="0.001" iyy="0.001" izz="0.001" ixy="0" ixz="0" iyz="0"/></inertial></link>
  <joint name="joint3_leg2" type="revolute"><parent link="leg2_joint1_link"/><child link="leg2_joint2_link"/><origin xyz="0.107210 -0.025964 -0.010750" rpy="0 0 0"/><axis xyz="0 1 0"/><limit lower="-1.570796" upper="1.570796" effort="10" velocity="2.618"/></joint>
  <link name="leg2_joint3_link"><visual><origin xyz="-0.204120 -0.147736 -0.101186" rpy="0 0 0"/><geometry><mesh filename="package://bob_description/meshes/leg2_part3.stl"/></geometry></visual><inertial><mass value="0.2"/><inertia ixx="0.001" iyy="0.001" izz="0.001" ixy="0" ixz="0" iyz="0"/></inertial></link>
  <joint name="joint4_leg2" type="revolute"><parent link="leg2_joint2_link"/><child link="leg2_joint3_link"/><origin xyz="0.107210 0.033700 -0.000014" rpy="0 0 0"/><axis xyz="0 1 0"/><limit lower="-1.570796" upper="1.570796" effort="10" velocity="2.618"/></joint>
  <link name="leg3_mount"><visual><origin xyz="0 0 0" rpy="0 0 0"/><geometry><mesh filename="package://bob_description/meshes/leg3_part0.stl"/></geometry></visual><inertial><mass value="0.1"/><inertia ixx="0.001" iyy="0.001" izz="0.001" ixy="0" ixz="0" iyz="0"/></inertial></link>
  <joint name="leg3_mount_fixed" type="fixed"><parent link="base_link"/><child link="leg3_mount"/><origin xyz="0 0 0" rpy="0 0 0"/></joint>
  <link name="leg3_joint1_link"><visual><origin xyz="0.010300 0.086000 -0.111950" rpy="0 0 0"/><geometry><mesh filename="package://bob_description/meshes/leg3_part1.stl"/></geometry></visual><inertial><mass value="0.2"/><inertia ixx="0.001" iyy="0.001" izz="0.001" ixy="0" ixz="0" iyz="0"/></inertial></link>
  <joint name="joint1_leg3" type="revolute"><parent link="leg3_mount"/><child link="leg3_joint1_link"/><origin xyz="-0.010300 -0.086000 0.111950" rpy="0 0 0"/><axis xyz="0 0 1"/><limit lower="-1.570796" upper="1.570796" effort="10" velocity="2.618"/></joint>
  <link name="leg3_joint2_link"><visual><origin xyz="-0.096910 0.111964 -0.101200" rpy="0 0 0"/><geometry><mesh filename="package://bob_description/meshes/leg3_part2.stl"/></geometry></visual><inertial><mass value="0.2"/><inertia ixx="0.001" iyy="0.001" izz="0.001" ixy="0" ixz="0" iyz="0"/></inertial></link>
  <joint name="joint3_leg3" type="revolute"><parent link="leg3_joint1_link"/><child link="leg3_joint2_link"/><origin xyz="0.107210 -0.025964 -0.010750" rpy="0 0 0"/><axis xyz="0 1 0"/><limit lower="-1.570796" upper="1.570796" effort="10" velocity="2.618"/></joint>
  <link name="leg3_joint3_link"><visual><origin xyz="-0.204120 0.078264 -0.101186" rpy="0 0 0"/><geometry><mesh filename="package://bob_description/meshes/leg3_part3.stl"/></geometry></visual><inertial><mass value="0.2"/><inertia ixx="0.001" iyy="0.001" izz="0.001" ixy="0" ixz="0" iyz="0"/></inertial></link>
  <joint name="joint4_leg3" type="revolute"><parent link="leg3_joint2_link"/><child link="leg3_joint3_link"/><origin xyz="0.107210 0.033700 -0.000014" rpy="0 0 0"/><axis xyz="0 1 0"/><limit lower="-1.570796" upper="1.570796" effort="10" velocity="2.618"/></joint>
</robot>
