Arkrez/bob/rl/nav_eval.py

"""Score a goal-reaching navigator (or the scripted baseline) on random goals, with the camera model.

    .venv/bin/python nav_eval.py policies/rocky_nav.npz
    .venv/bin/python nav_eval.py baseline
    .venv/bin/python nav_eval.py policies/rocky_nav.npz --video nav.mp4
    .venv/bin/python nav_eval.py baseline --obstacles      walls and boxes in the way (lidar navigators)
    .venv/bin/python nav_eval.py blind --obstacles         the scripted navigator ignoring its lidar
    .venv/bin/python nav_eval.py policies/rocky_nav_lidar.npz --obstacles --hybrid   scripted search when lost

Each run is 60 s on medium terrain with shoves and randomised physics; goals keep appearing
0.5-2.5 m away in random directions. Reports goals per minute, time to each goal, path
efficiency (straight-line distance / distance walked), sideways command use, falls, and how fast
he locates each new goal (seconds until it's first in view). With --obstacles, also bumps per
minute and the share of time stuck.
"""

import argparse

import numpy as np

from camera import CAMERA_X
from nav_env import RockyBobNavigate
from nav_spec import NAV_DT, NAV_OBS, HybridNavigator, PlannerNavigator, ScriptedNavigator, command_to_action
from policy import NumpyPolicy

TERRAIN = (0.3, 0.3)


def baseline():
    """The scripted navigator, with its explore-when-lost search (nav_spec.ScriptedNavigator)."""
    return ScriptedNavigator()


FIND_MIN = 5.0   # s: a goal still unseen at the end counts (as the time so far) only after this long


def run(nav, seed, seconds=60, frames=None, obstacles=False, hybrid=False, goals="random", walker=None):
    env = RockyBobNavigate(episode_seconds=seconds, terrain=TERRAIN, obstacles=obstacles, goals=goals,
                           **({"walker": walker} if walker else {}))
    obs, _ = env.reset(seed=seed)
    if nav == "planner":
        scripted = PlannerNavigator()
    else:
        scripted = baseline() if nav in ("baseline", "blind") else (HybridNavigator(nav) if hybrid else None)
    # what each navigator can see: "blind" and camera-only networks get no lidar
    width = NAV_OBS if nav == "blind" or (scripted is None and nav.mean.shape[0] == NAV_OBS) else len(obs)
    stuck = 0
    times, effs, sideways, arcing, fell = [], [], [], [], False
    t_goal, path, start = 0.0, 0.0, env.walk.data.qpos[:2].copy()
    finds, found = [], False
    straight = float(np.linalg.norm(env.goal - start))
    prev = start.copy()
    done = False
    while not done:
        o = obs[:width]
        action = command_to_action(scripted(o)) if scripted is not None else nav(o)
        reached_before = env.reached
        obs, _, fell, trunc, info = env.step(action)
        pos = env.walk.data.qpos[:2].copy()
        path += float(np.linalg.norm(pos - prev))
        prev = pos
        t_goal += NAV_DT
        if not found and info["visible"]:
            finds.append(t_goal)
            found = True
        sideways.append(abs(info["cmd"][1]))
        stuck += int(info["stuck"])
        arcing.append(abs(info["cmd"][2]) > 0.15 and info["cmd"][0] > 0.05)
        if frames is not None:
            frames.append(env.render())
        if env.reached > reached_before:
            times.append(t_goal)
            effs.append(straight / max(path, 1e-6))
            t_goal, path, found = 0.0, 0.0, False
            straight = float(np.linalg.norm(env.goal - pos))
        done = fell or trunc
    if not found and t_goal >= FIND_MIN:
        finds.append(t_goal)
    return (env.reached, times, effs, float(np.mean(sideways)), fell, float(np.mean(arcing)),
            env.bumps * 60 / max(env.steps * NAV_DT, 1e-6), stuck / max(env.steps, 1), finds)


def main():
    p = argparse.ArgumentParser()
    p.add_argument("policy", help="navigator .npz, 'planner' (memory + free-path steering), 'baseline' (scripted) "
                                  "or 'blind' (scripted, no lidar)")
    p.add_argument("--obstacles", action="store_true", help="random walls and boxes in the way")
    p.add_argument("--hybrid", action="store_true", help="a trained navigator, with the scripted search when lost")
    p.add_argument("--goals", default="random", choices=("random", "near", "hidden", "mixed", "prey"),
                   help="with --obstacles: where goals go (near = 0.3-0.5 m from an obstacle, hidden = behind one)")
    p.add_argument("--runs", type=int, default=6)
    p.add_argument("--seconds", type=float, default=60)
    p.add_argument("--walker", help="walker .npz to drive (default policies/rocky_walk.npz)")
    p.add_argument("--video", help="record the first run to this mp4")
    args = p.parse_args()
    nav = args.policy if args.policy in ("baseline", "blind", "planner") else NumpyPolicy(args.policy)

    goals, times, effs, side, falls, arcs, bumps, stuck, finds = [], [], [], [], 0, [], [], [], []
    frames = [] if args.video else None
    for i in range(args.runs):
        g, t, e, s, f, a, b, k, fd = run(nav, seed=500 + i, seconds=args.seconds, frames=frames if i == 0 else None,
                                         obstacles=args.obstacles, hybrid=args.hybrid, goals=args.goals, walker=args.walker)
        goals.append(g); times += t; effs += e; side.append(s); falls += int(f); arcs.append(a); finds += fd
        bumps.append(b); stuck.append(k)
    print(f"{args.policy}: {np.mean(goals) * 60 / args.seconds:.1f} goals/min (range {min(goals)}-{max(goals)}) | "
          f"time to goal median {np.median(times) if times else float('nan'):.1f} s | "
          f"time to find mean {np.mean(finds) if finds else float('nan'):.1f} s | "
          f"path efficiency {np.mean(effs) if effs else float('nan'):.0%} | "
          f"sideways cmd {np.mean(side):.3f} m/s | arcing {np.mean(arcs):.0%} | falls {falls}/{args.runs}"
          + (f" | bumps {np.mean(bumps):.2f}/min | stuck {np.mean(stuck):.0%}" if args.obstacles else ""))
    if args.video:
        import imageio
        imageio.mimsave(args.video, frames, fps=int(1 / NAV_DT), macro_block_size=8)
        print(f"wrote {args.video}")


if __name__ == "__main__":
    main()
