Arkrez/bob/(commit log)

2026-10-04 Reframe README around motorcycle chain lubrication mission
2026-10-04 Rewrite README around the chain-lubrication problem and component rationale
2026-10-13 Replace legacy robot simulation assets with CAD-derived Bob model
2026-10-13 Connect Bob CAD Webots actuators to existing ROS 2 motion commands
2026-10-23 Add Rocky-Bob: rock body, RL walk/run gait, camera navigation and sim tooling
    - cad/rocky_bob: parametric CadQuery rock body (pop-off lid, Pi 5 / Servo 2040
    mounts, PSU bay, Pi camera window), rock-styled MG995 legs, STEP/STL exports,
    URDF and Webots PROTO/world generated from the same model
    - rl: MuJoCo model generated from the URDF, PPO walking env (rough terrain
    curriculum, shoves, smoothness, servo-limit, foot-clearance and stable-body
    rewards, speed-dependent gait clock for walk/run), training, evaluation,
    viewers, trained policies, Pi camera model, scripted turn-then-go navigator,
    trained navigator, and ROS/Pi nodes for the real robot
    - webots bridge: lockstep policy mode w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
2026-10-23 Pivot turns in place: fewer steps, stay over the starting spot
    - env: turn-in-place rewards (pivot anchor bonus, per-footfall cost, body
    drift cost) and a slower 1.0 s turning stride (spec.TURN_PERIOD)
    - policies: rocky_walk.npz is now the pivot walker (walk_pivot 30M):
    20.5 footfalls/rad (was 23.7), 7.2 cm drift (was 11.8), walking and
    running 11-16% slower; the faster walk_run 22M walker is kept as
    rocky_walk_run22.npz (needs TURN_PERIOD = 0.6)
    - turn_eval.py: footfalls per radian, drift and turn rate when pivoting
    - train.py: resume with matching input scaling (--obs-stats), and save
    VecNormalize alongside checkpoints so resumed runs aren't crippled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
2026-10-23 HobbyPark 25 kg servos, clean-step walker, Webots fixes and obstacle world
    - servo: model the HobbyPark 25 kg coreless servo at 7.4 V (2.45 N m stall,
    ~8 rad/s) from one place (rl/spec.py); CAD pockets/holes (49.5 x 10 mm),
    servo mass, URDF limits and Webots motors all follow it
    - walker (rocky_walk.npz = walk_hp4 42M): trained for the new servo with a
    4.5 cm target step height, even steps across legs, bounce penalty,
    stricter pivot rewards (anchor, linear offset, slide, no planted pivot
    leg) and a run-progress reward; ~4 cm even steps, near-zero bounces,
    14 footfalls/rad, faster walk/run; previous walker kept as
    rocky_walk_pivot_mg995.npz
    - camera: detection range now derived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
2026-10-24 Rocky-Bob: lidar, floor sensor, navigation, stairs, self-righting, demos
    - Lidar (RPLIDAR C1) on the lid and a ToF floor sensor (VL53L5CX) in the
    nose: CAD mounts, MuJoCo rays, Webots devices, /scan and /tof topics,
    and a live point-cloud viewer (rl/scan_viewer.py)
    - Planner navigator: target memory, free-path steering, lidar safety
    layer, stuck escape, and floor-sensor step/cliff detection
    - Walker: full servo range, floor heights as inputs, varied stairs
    curriculum (pyramids, flights, kerbs, pits, uneven), stair-quality
    rewards, mixed-difficulty terrain
    - Self-righting: learned roll-over plus scripted tidy-up, joint speed
    cap, lidar-contact and impact penalties
    - Training loop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
2026-10-24 Run Bob's sim and training on Windows too
    - PowerShell setup (winget: Git, Python 3.12, Docker Desktop, Webots), sim,
    ROS, demo and training scripts mirroring the macOS ones
    - Python: spawn workers where forkserver is missing, a portable single-
    session lock, psutil instead of pgrep, keep the PC awake while training,
    nice only where it exists; numpy, cloudpickle, matplotlib, psutil added
    to rl/requirements.txt
    - .gitattributes keeps LF endings on files the Linux container runs
2026-10-25 Rocky-Bob: tall steps and ledges, target-finding score, chase mode
    - Training: stair practice now also puts 1-3 taller steps (5-6 cm, ramping
    towards 10 cm as he reaches the top) or a 12-30 cm ledge in his path.
    Belly contact is allowed on a ledge; the lidar touching anything ends
    the episode. Platforms go up to 10 cm.
    - keep_best.py scores tall stairs and ledges separately ("tall") and how
    fast the planner finds a hidden goal with each walker ("find s").
    nav_eval.py reports time to find; nav rounds subtract it.
    - Webots: three 10 cm stairs and a 30 cm ledge, with "tall" and "ledge"
    demos that drive him at them through a /cmd_vel override.
    - Chase mode (start_sim.sh --world chase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
2026-10-26 Rocky-Bob: all-stairs training, per-round seeds, 88% self-righting
    - env.py: every training episode is stair practice (STAIR_PRACTICE 1.0),
    and tall steps ramp from 6 cm towards 10 cm with tall_level.
    - train.py: apply the round's seed after PPO.load. The seed saved in the
    checkpoint was overriding it, so every round resumed from the same
    champion replayed exactly the same run.
    - rocky_recover.npz: round_r0051 80M, recovers from 88% of falls (was 79%).
2026-10-26 README: Bob as a general robot identity, with pictures of Rocky-Bob
    - Rewrite the README intro: Bob is a general autonomous robot, one central
    identity that can be loaded into different bodies; Rocky-Bob is the first.
    What he has, what he can do in simulation, and an up-to-date quick start.
    The older CAD model's notes are grouped under their own heading.
    - docs/images: printed-part renders, MuJoCo renders (standing, training
    terrain) and Webots screenshots (arena, stairs, 10 cm stairs).
    - rl/render_images.py redraws the CAD and MuJoCo images.
    - Webots bridge: /screenshot topic saves the 3D view, optionally from a
    given eye point and look-at point.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
